iankeeffe1/hellen-example/boards/hellen64_miataNA6_94-a/board/misc/hellen64_miataNA6_94-a-bottom.png

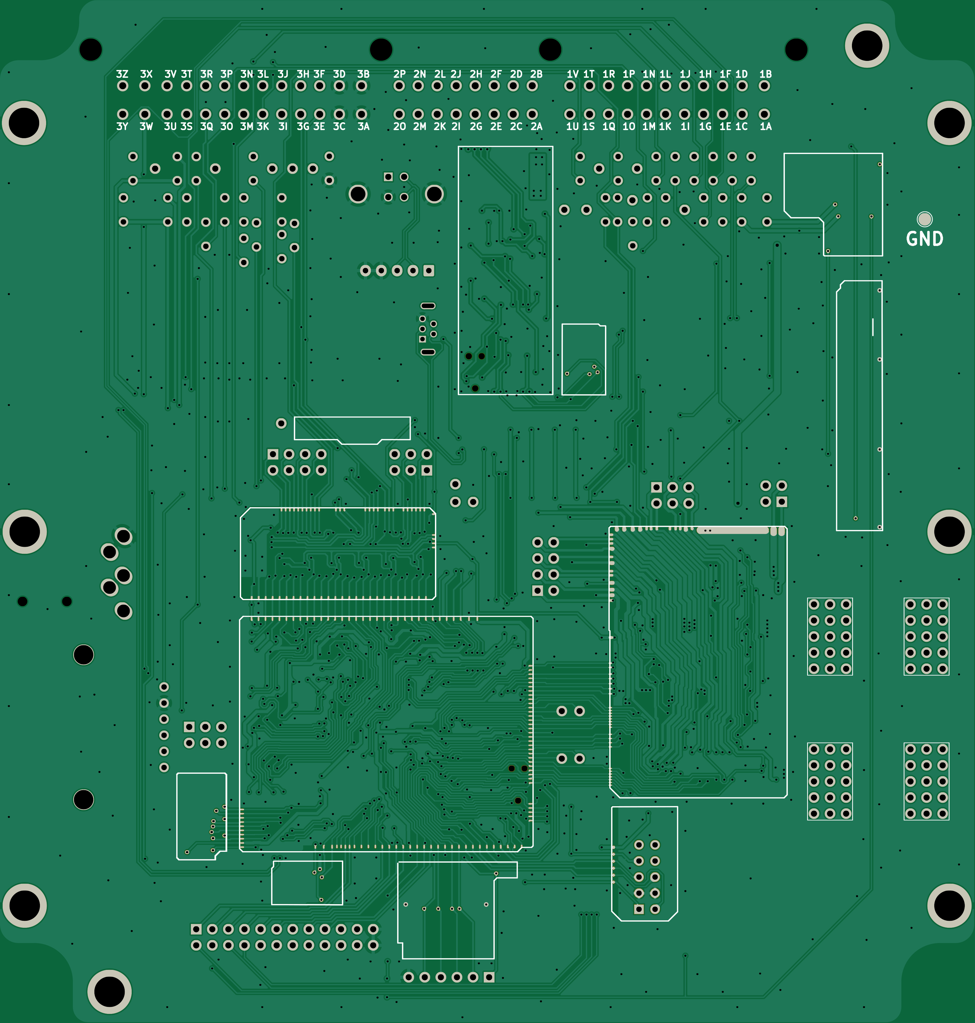
boards/hellen64_miataNA6_94-a/board/misc/hellen64_miataNA6_94-a-bottom.png
