iankeeffe1/hellen-example/boards/hellen64_miataNA6_94-a/board/Produce_DanZhi.SMT_Original_Snapshot.Top.2582135A_Y98.SMT0210416179401.png

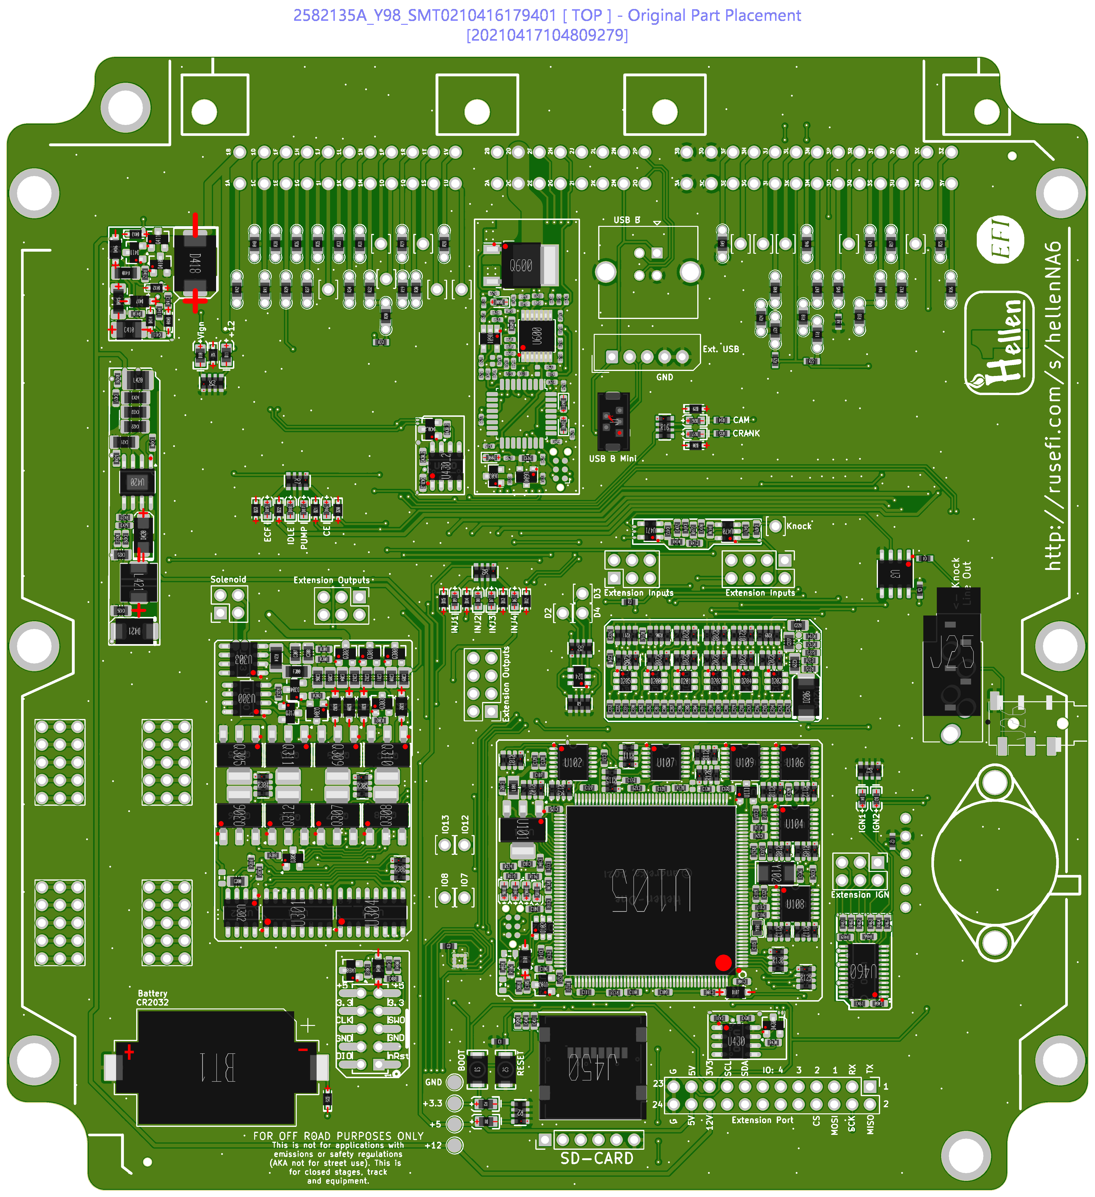
boards/hellen64_miataNA6_94-a/board/Produce_DanZhi.SMT_Original_Snapshot.Top.2582135A_Y98.SMT0210416179401.png
