iankeeffe1/hellen-example/boards/hellen64_miataNA6_94-b/board/hellen64_miataNA6_94-b.png

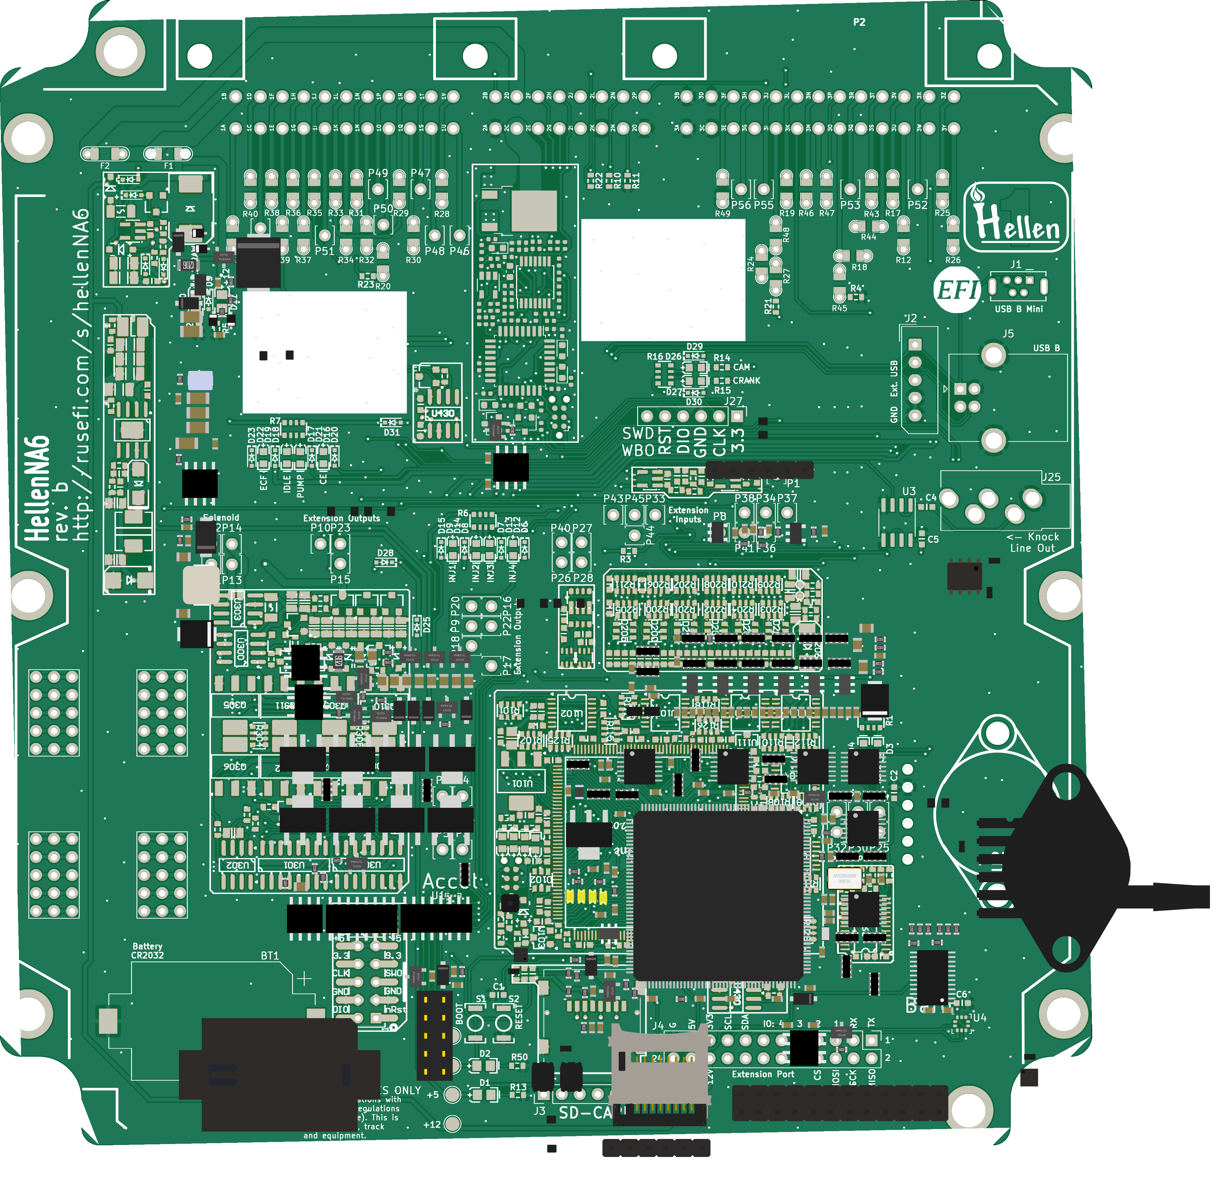
boards/hellen64_miataNA6_94-b/board/hellen64_miataNA6_94-b.png
