iankeeffe1/hellen-example/boards/hellen64_miataNA6_94-b/board/misc/hellen64_miataNA6_94-b-top.png

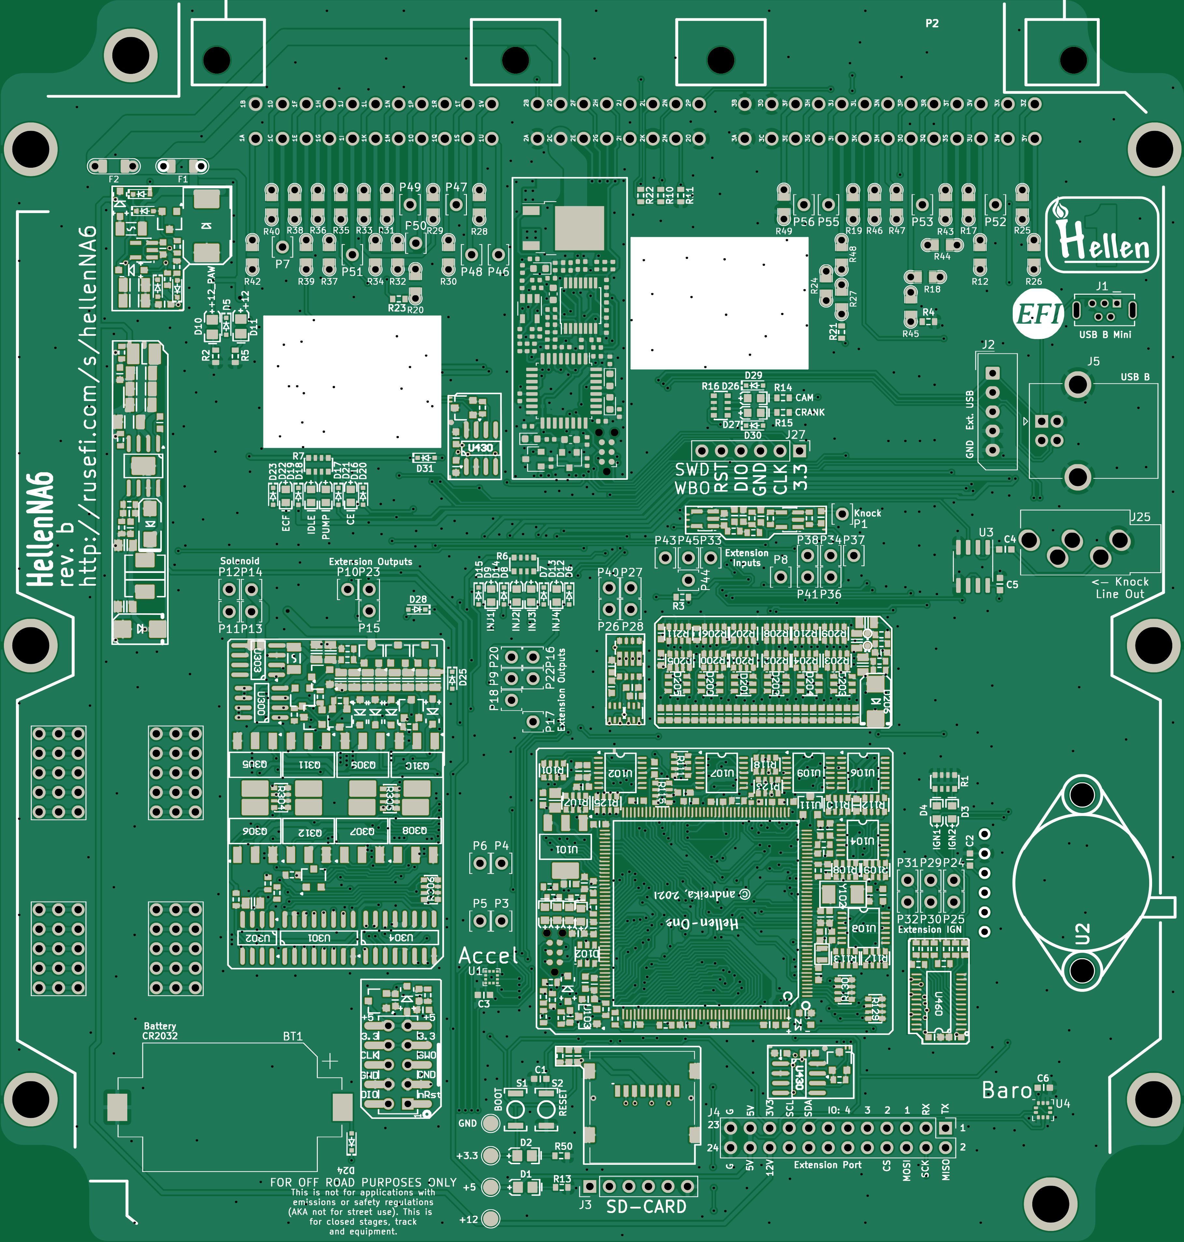
boards/hellen64_miataNA6_94-b/board/misc/hellen64_miataNA6_94-b-top.png
