iankeeffe1/hellen-example/boards/hellen64_NA6_94-c/board/hellen64_NA6_94-c.png

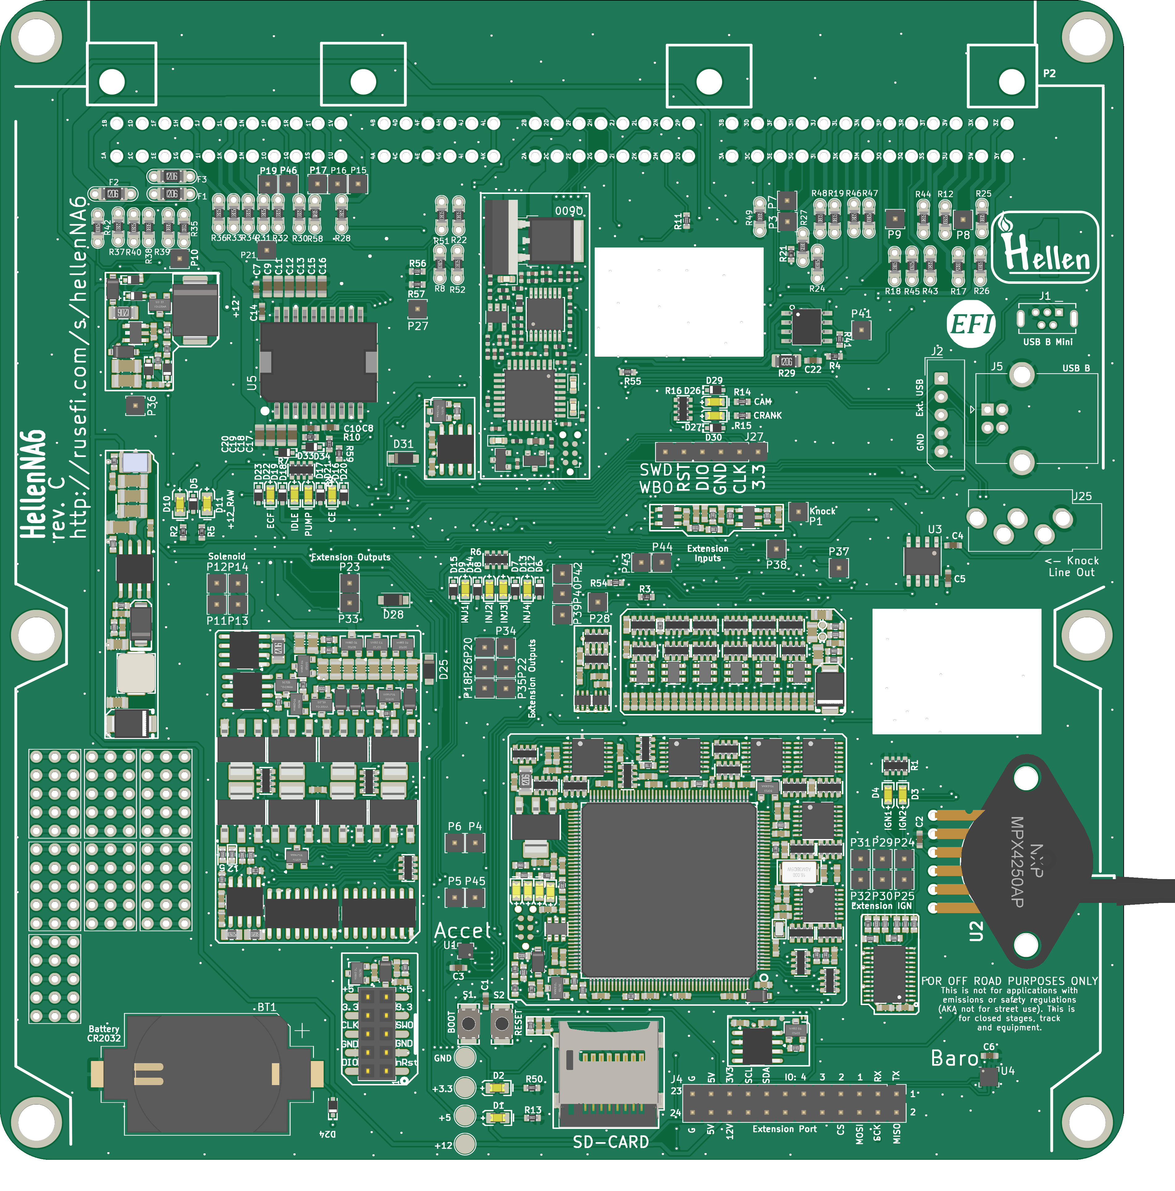
boards/hellen64_NA6_94-c/board/hellen64_NA6_94-c.png
