iankeeffe1/hellen-example/boards/hellen64_NA6_94-c/board/misc/hellen64_NA6_94-c-outline.png

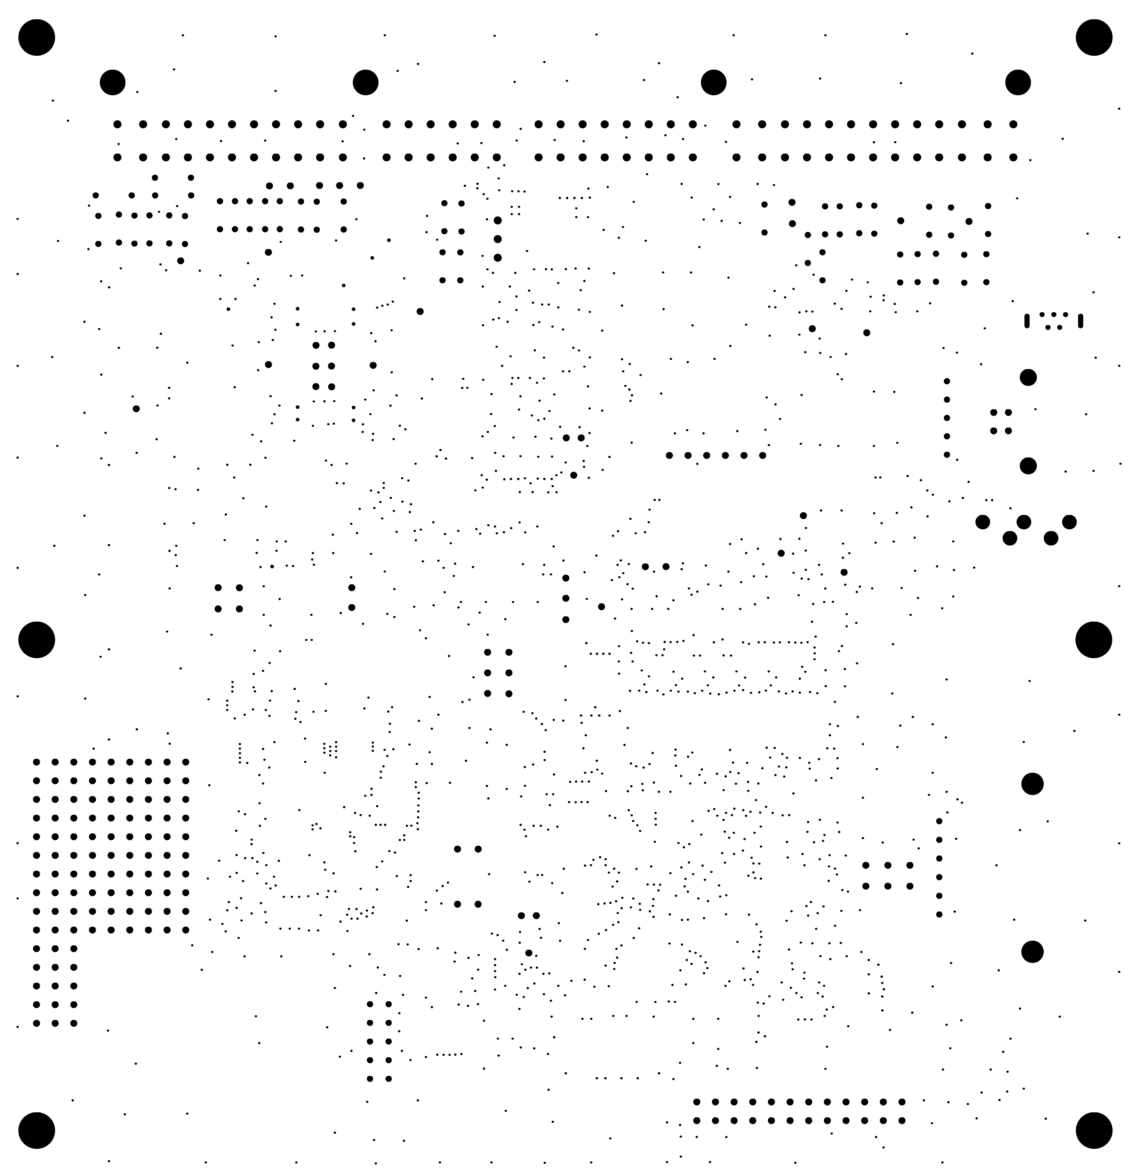
boards/hellen64_NA6_94-c/board/misc/hellen64_NA6_94-c-outline.png
