iankeeffe1/hellen-example/boards/hellen64_NA6_94-d/board/hellen64_NA6_94-d.png

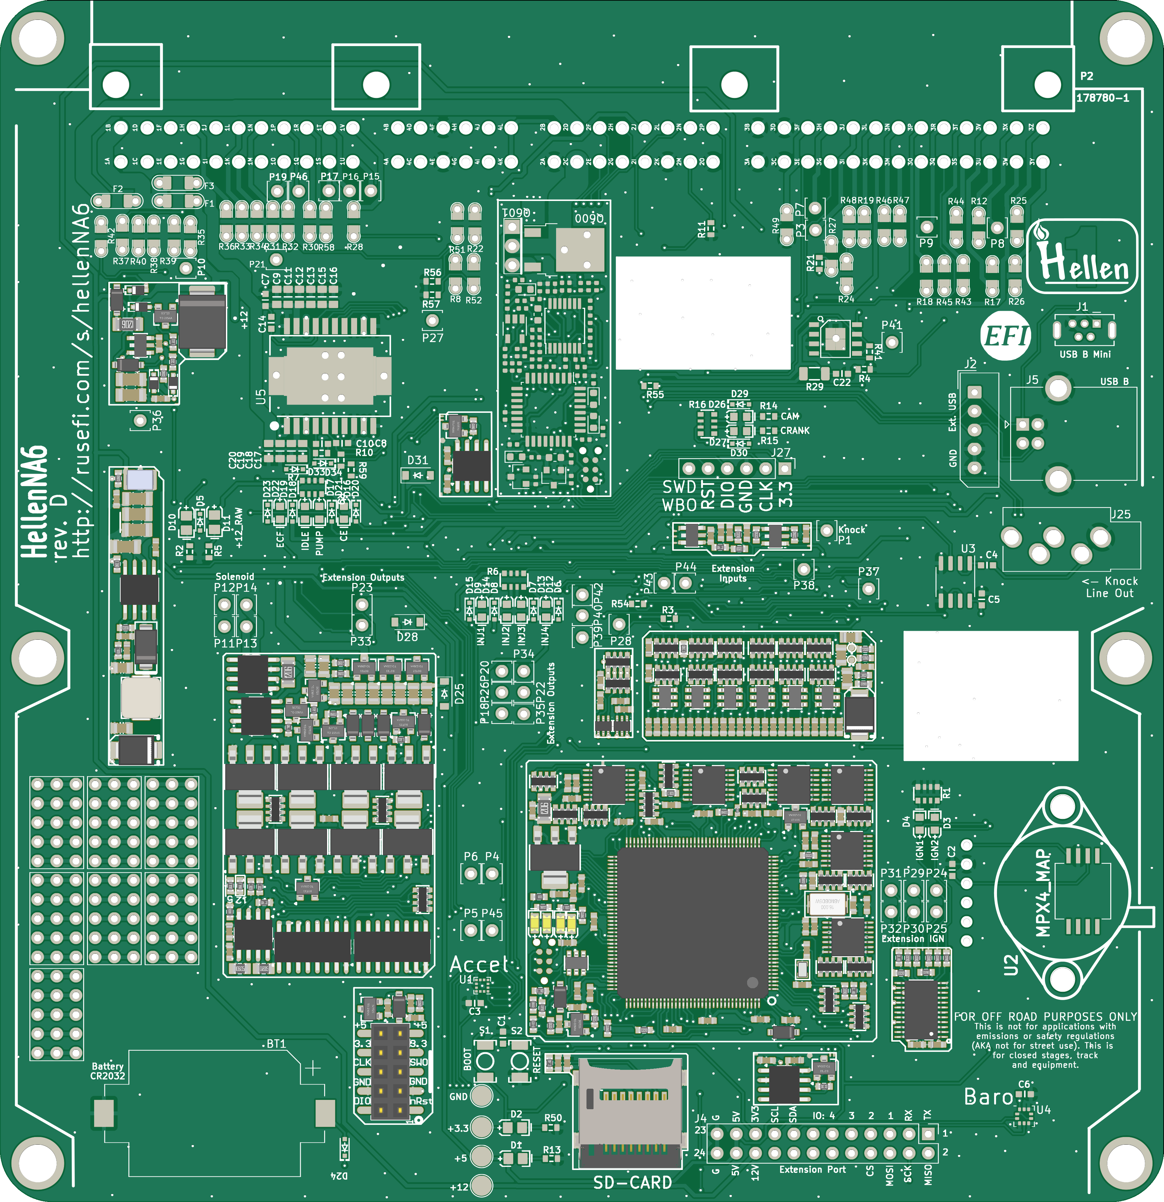
boards/hellen64_NA6_94-d/board/hellen64_NA6_94-d.png
