iankeeffe1/hellen-example/boards/hellen64_NA6_94-d/board/misc/hellen64_NA6_94-d-components.png

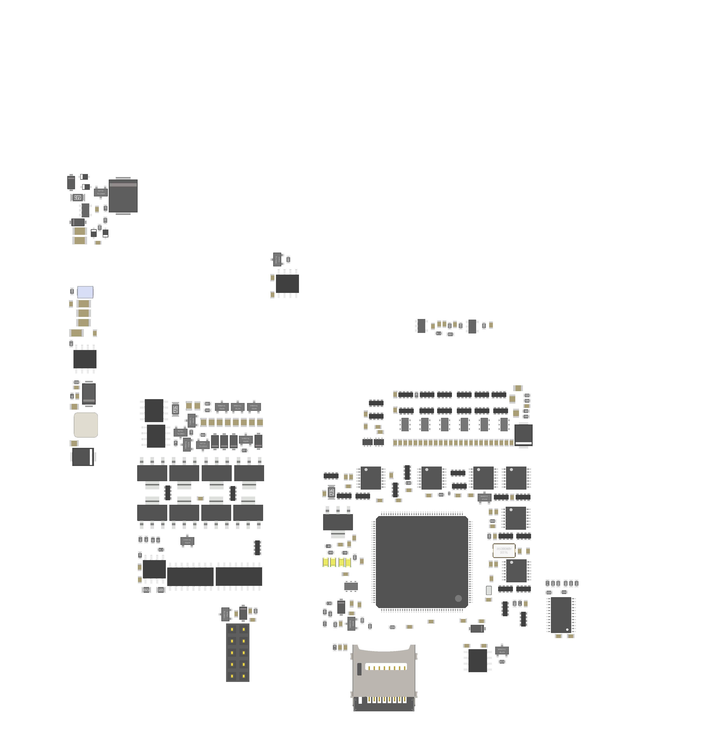
boards/hellen64_NA6_94-d/board/misc/hellen64_NA6_94-d-components.png
