iankeeffe1/hellen-example/boards/hellen64_miataNA6_94-a/board/hellen64_miataNA6_94-a-schematic.pdf

# P55 P52 P53P54 R43 R44 R45 R46 R47 R48 P56

1 D- 2 D+

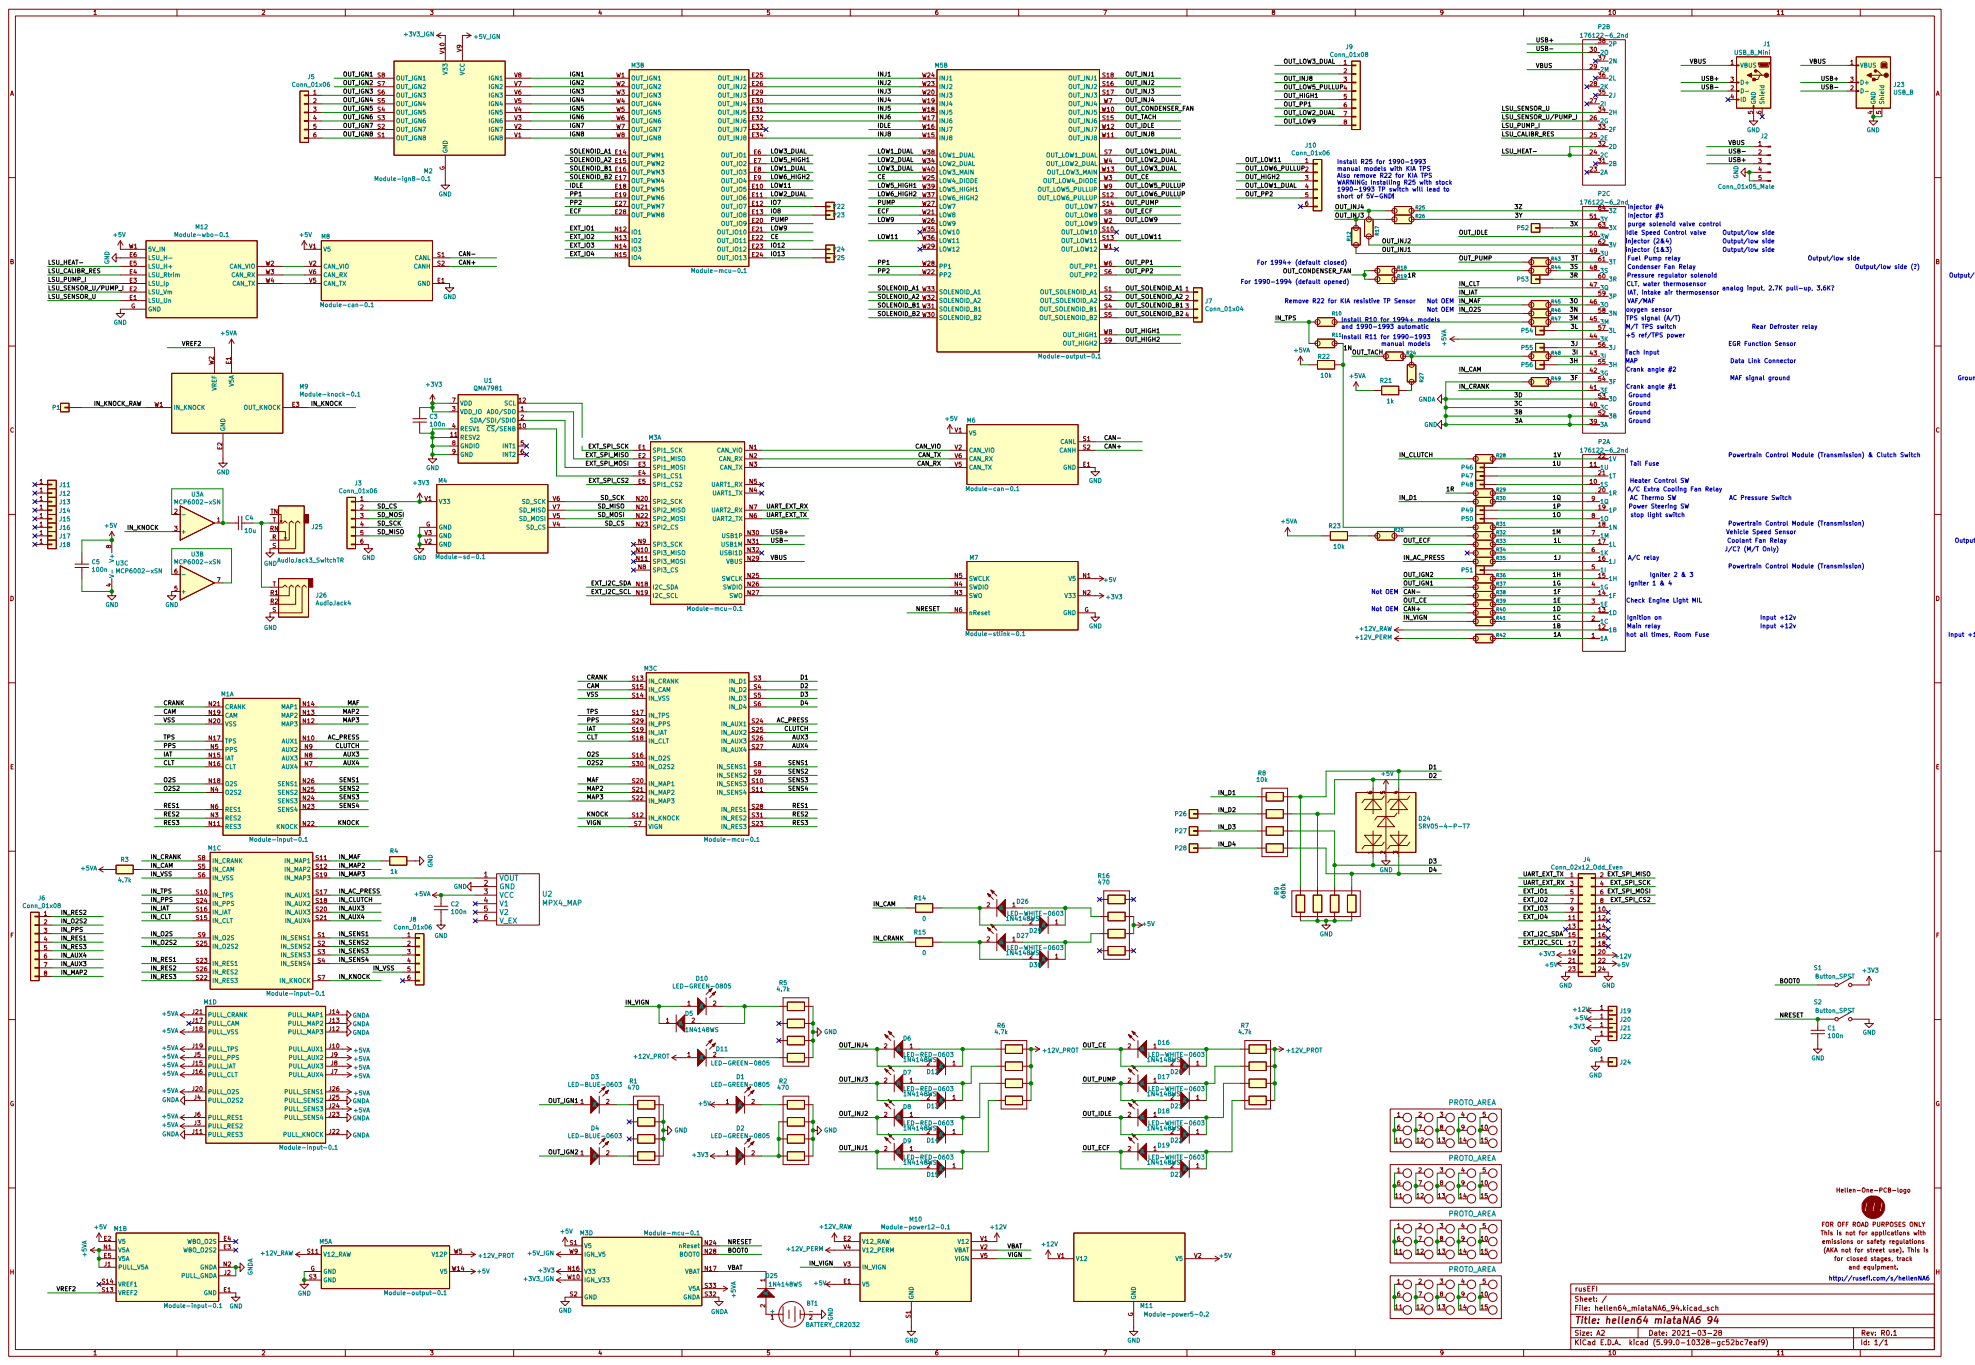
[picture p30: page 1]

Install R25 for 1990-1993 manual models with KIA TPS

Also remove R22 for KIA TPS WARNING: Installing R25 with stock 1990-1993 TP switch will lead to

Injector #4
Injector #3
purge solenoid valve control
Idle Speed Control valve
injector (2&4)
injector (1&3)
Fuel Pump relay Output/low side
Condenser Fan Relay Output/low side (?)
Pressure regulator solenoid Output/low side
IAT, intake air thermosensor CLT, water thermosensor oxygen sensor VAF/MAF

analog input, 2.7K pull-up, 3.6K?

Install R10 for 1994+ models and 1990-1993 automatic

TPS signal (A/T)
Crank angle #2 M/T TPS switch Tach Input
+5 ref/TPS power

MAF signal ground Ground Data Link Connector EGR Function Sensor

Ground Ground Ground MAPCrank angle #1

stop light switch Heater Control SW
A/C Extra Cooling Fan Relay

Coolant Fan Relay Output, low-side
J/C? (M/T Only)

Powertrain Control Module (Transmission)

Ignition on Input +12v Not OEM

Main relay Input +12v
hot all times, Room Fuse Input +12v

for closed stages, track FOR OFF ROAD PURPOSES ONLY
This is not for applications with
emissions or safety regulations
(AKA not for street use). This is

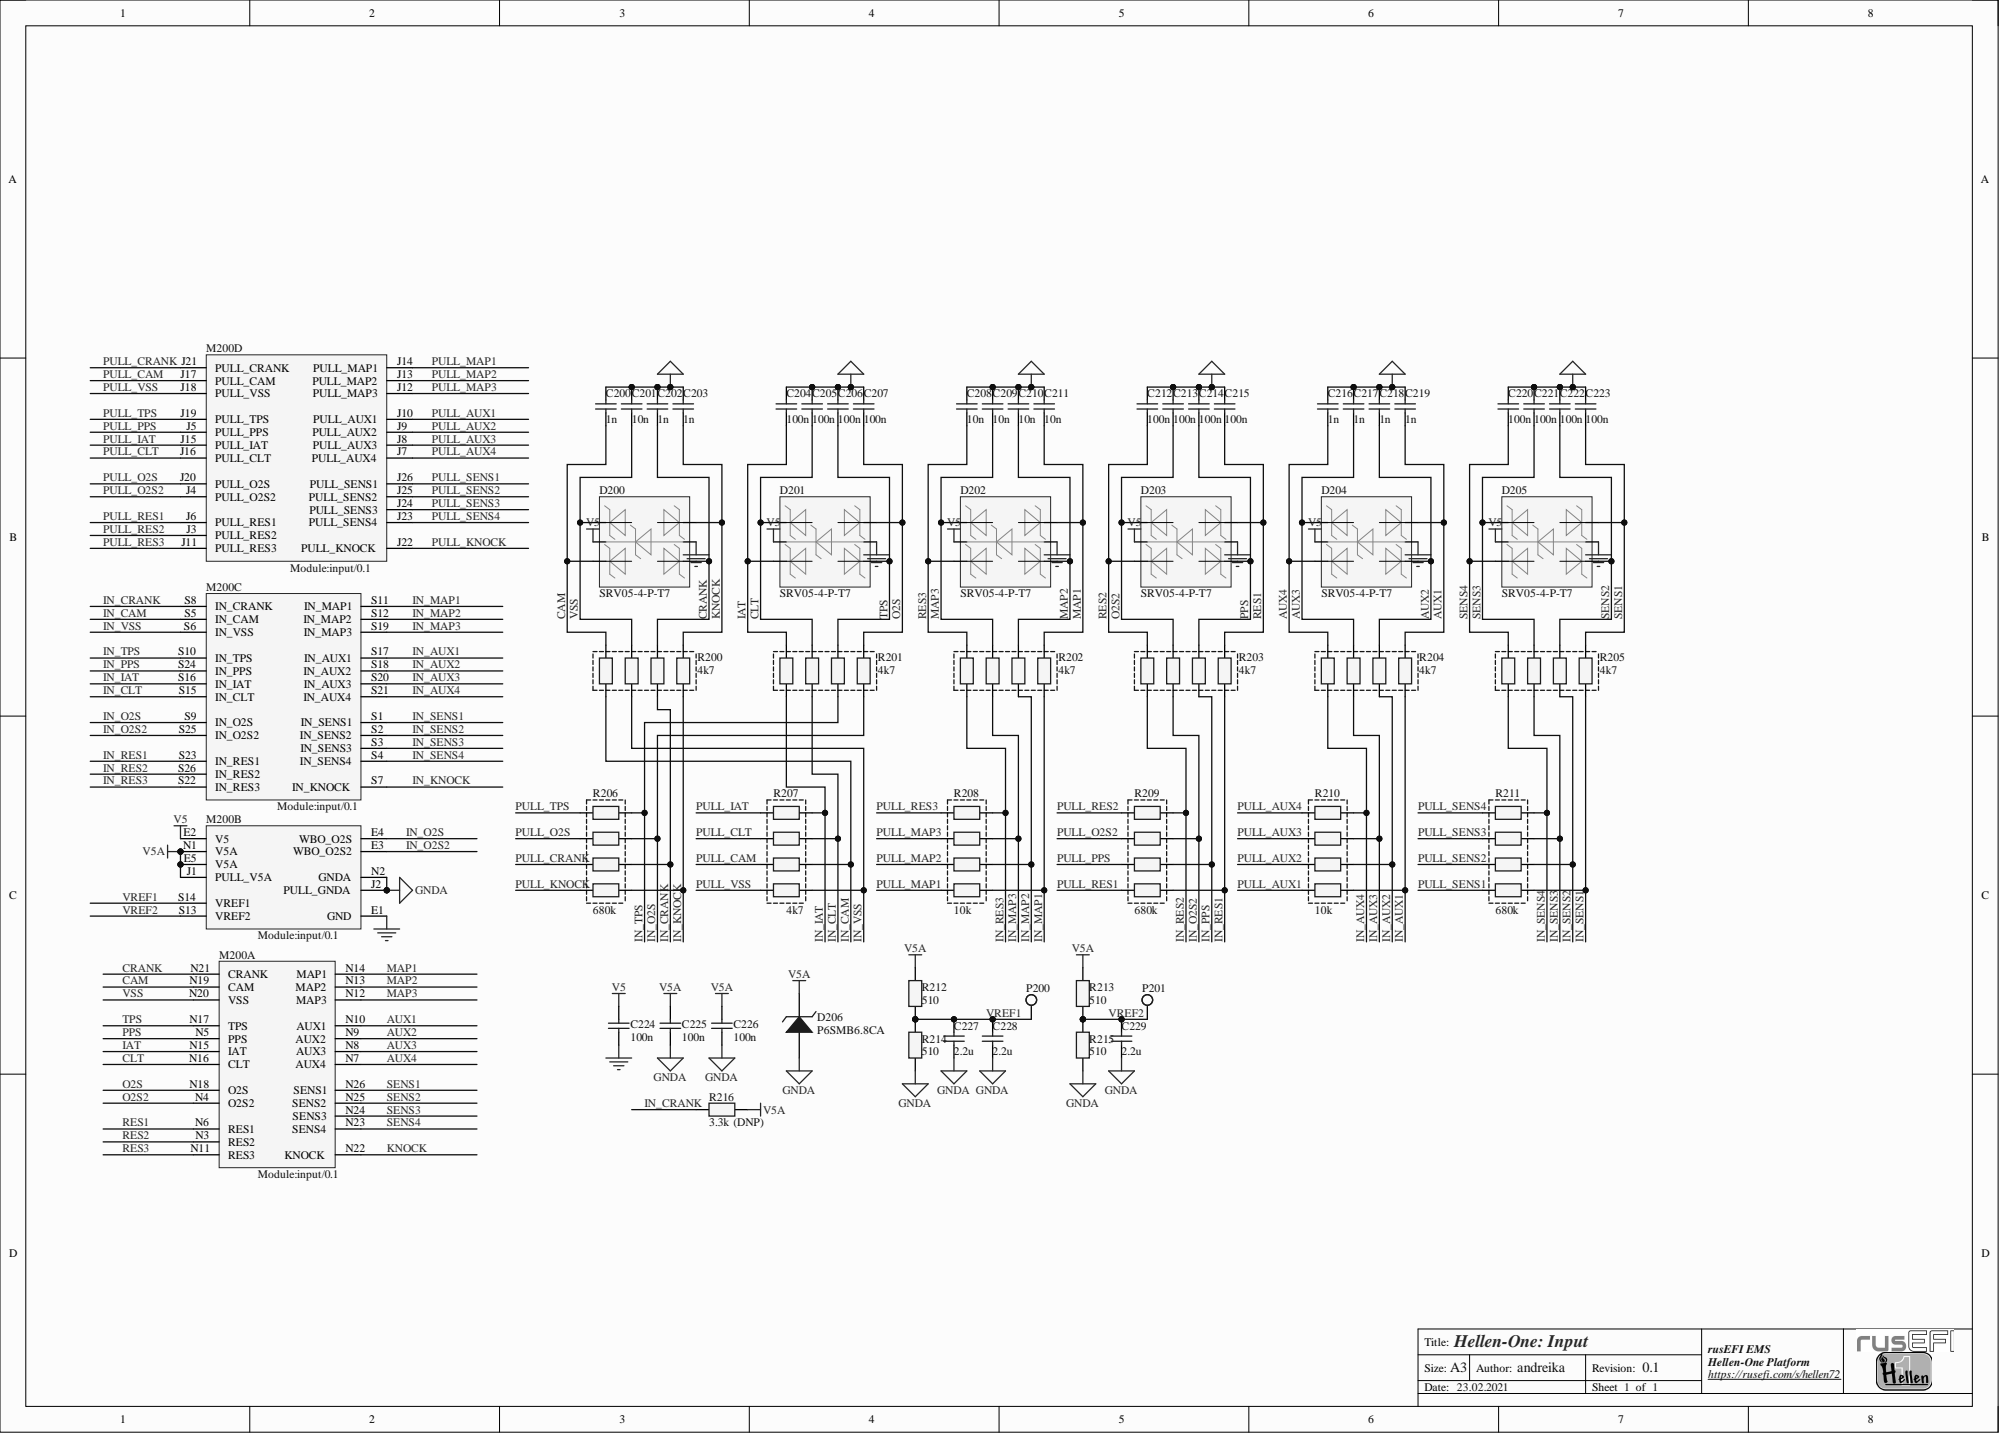
[picture p31: page 2]

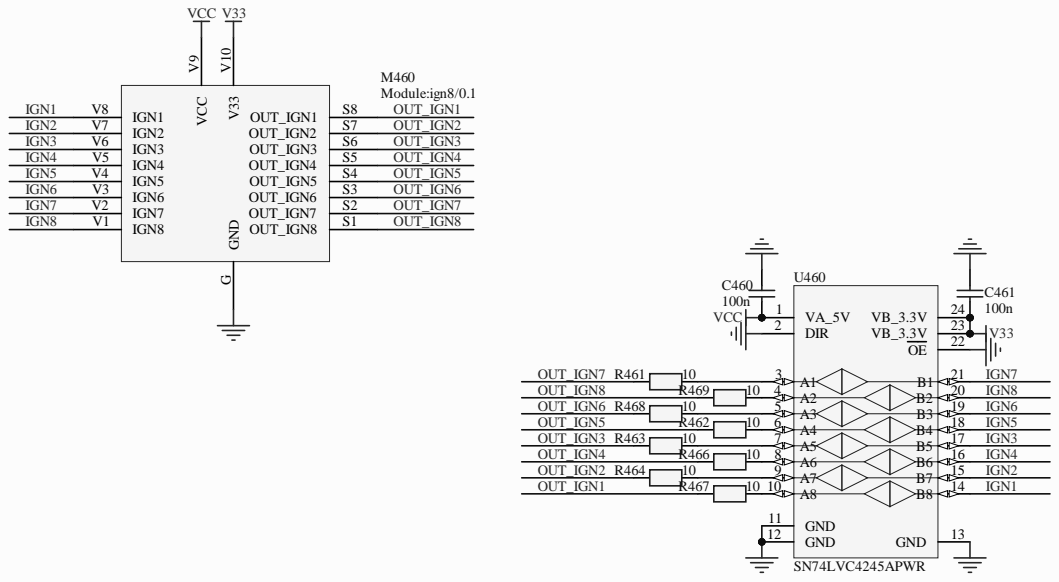
[picture p32: page 3]

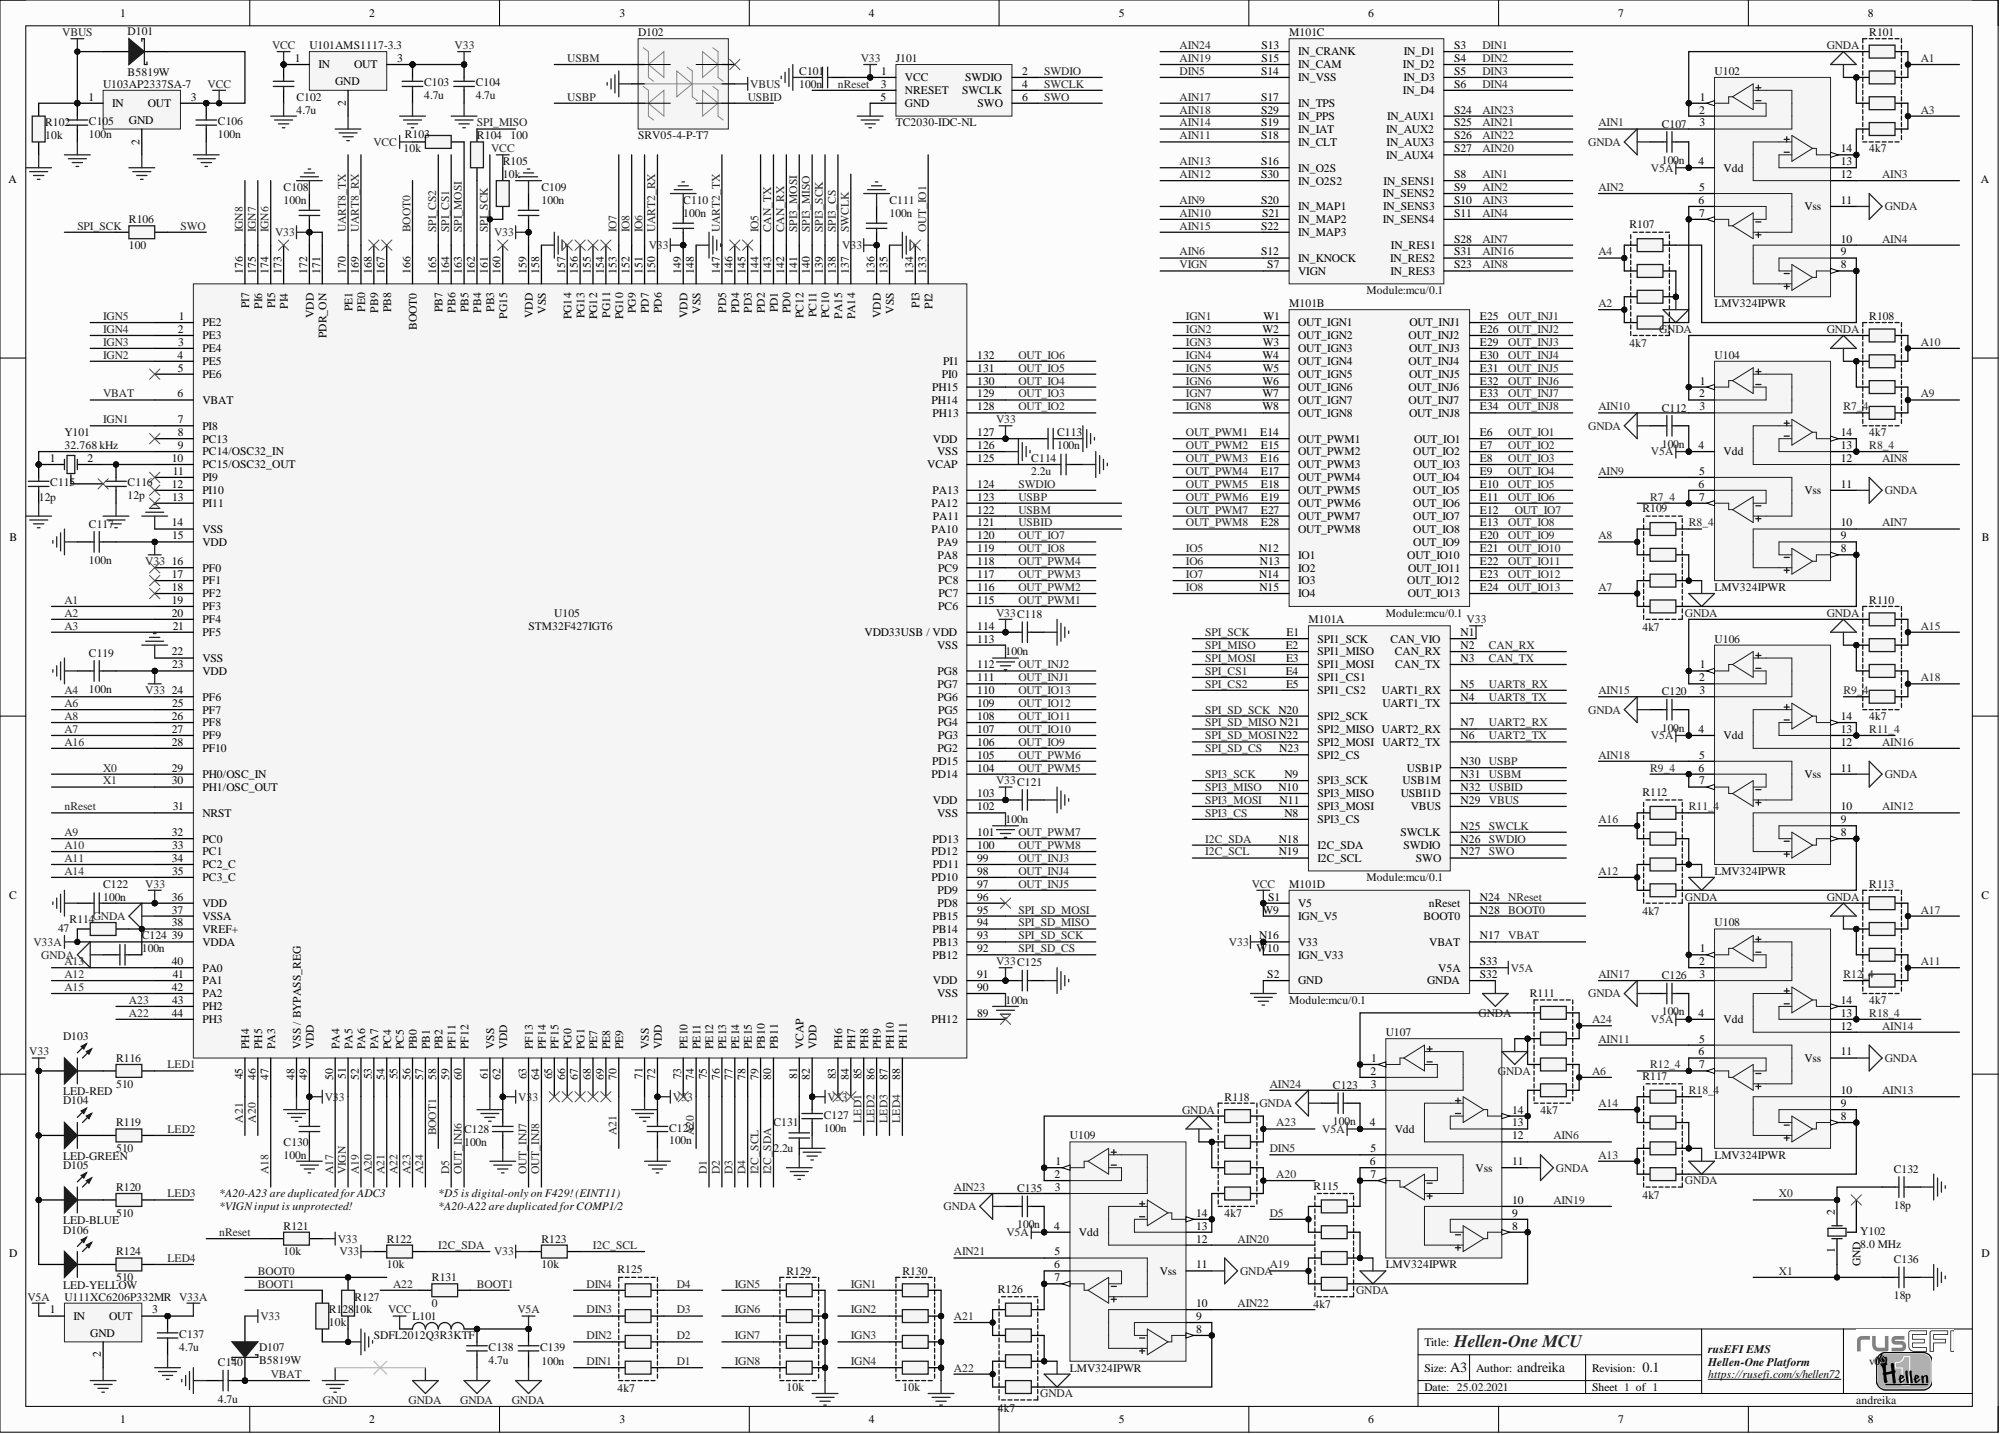
[picture p33: page 4]

D5 *D5 is digital-only on F429!(EINT11)

*A20-A23 are duplicated for ADC3
*VIGN input is unprotected!

2 SPI_I; 3 GND; 4 VCC; 5 SPI_SCK; 6 GND; 7 SPI_O; Molex MicroSD 47219-2001; GND; SD_CS SD_MOSI; SD_SCK; SD_MISO; V2 GND; SD_MOSI V5; SD_SCK V6 SD_MISO V7; Module:sd/0.1; SD_MOSI; SD_SCK SD_MISO

Hellen-One SD-Card

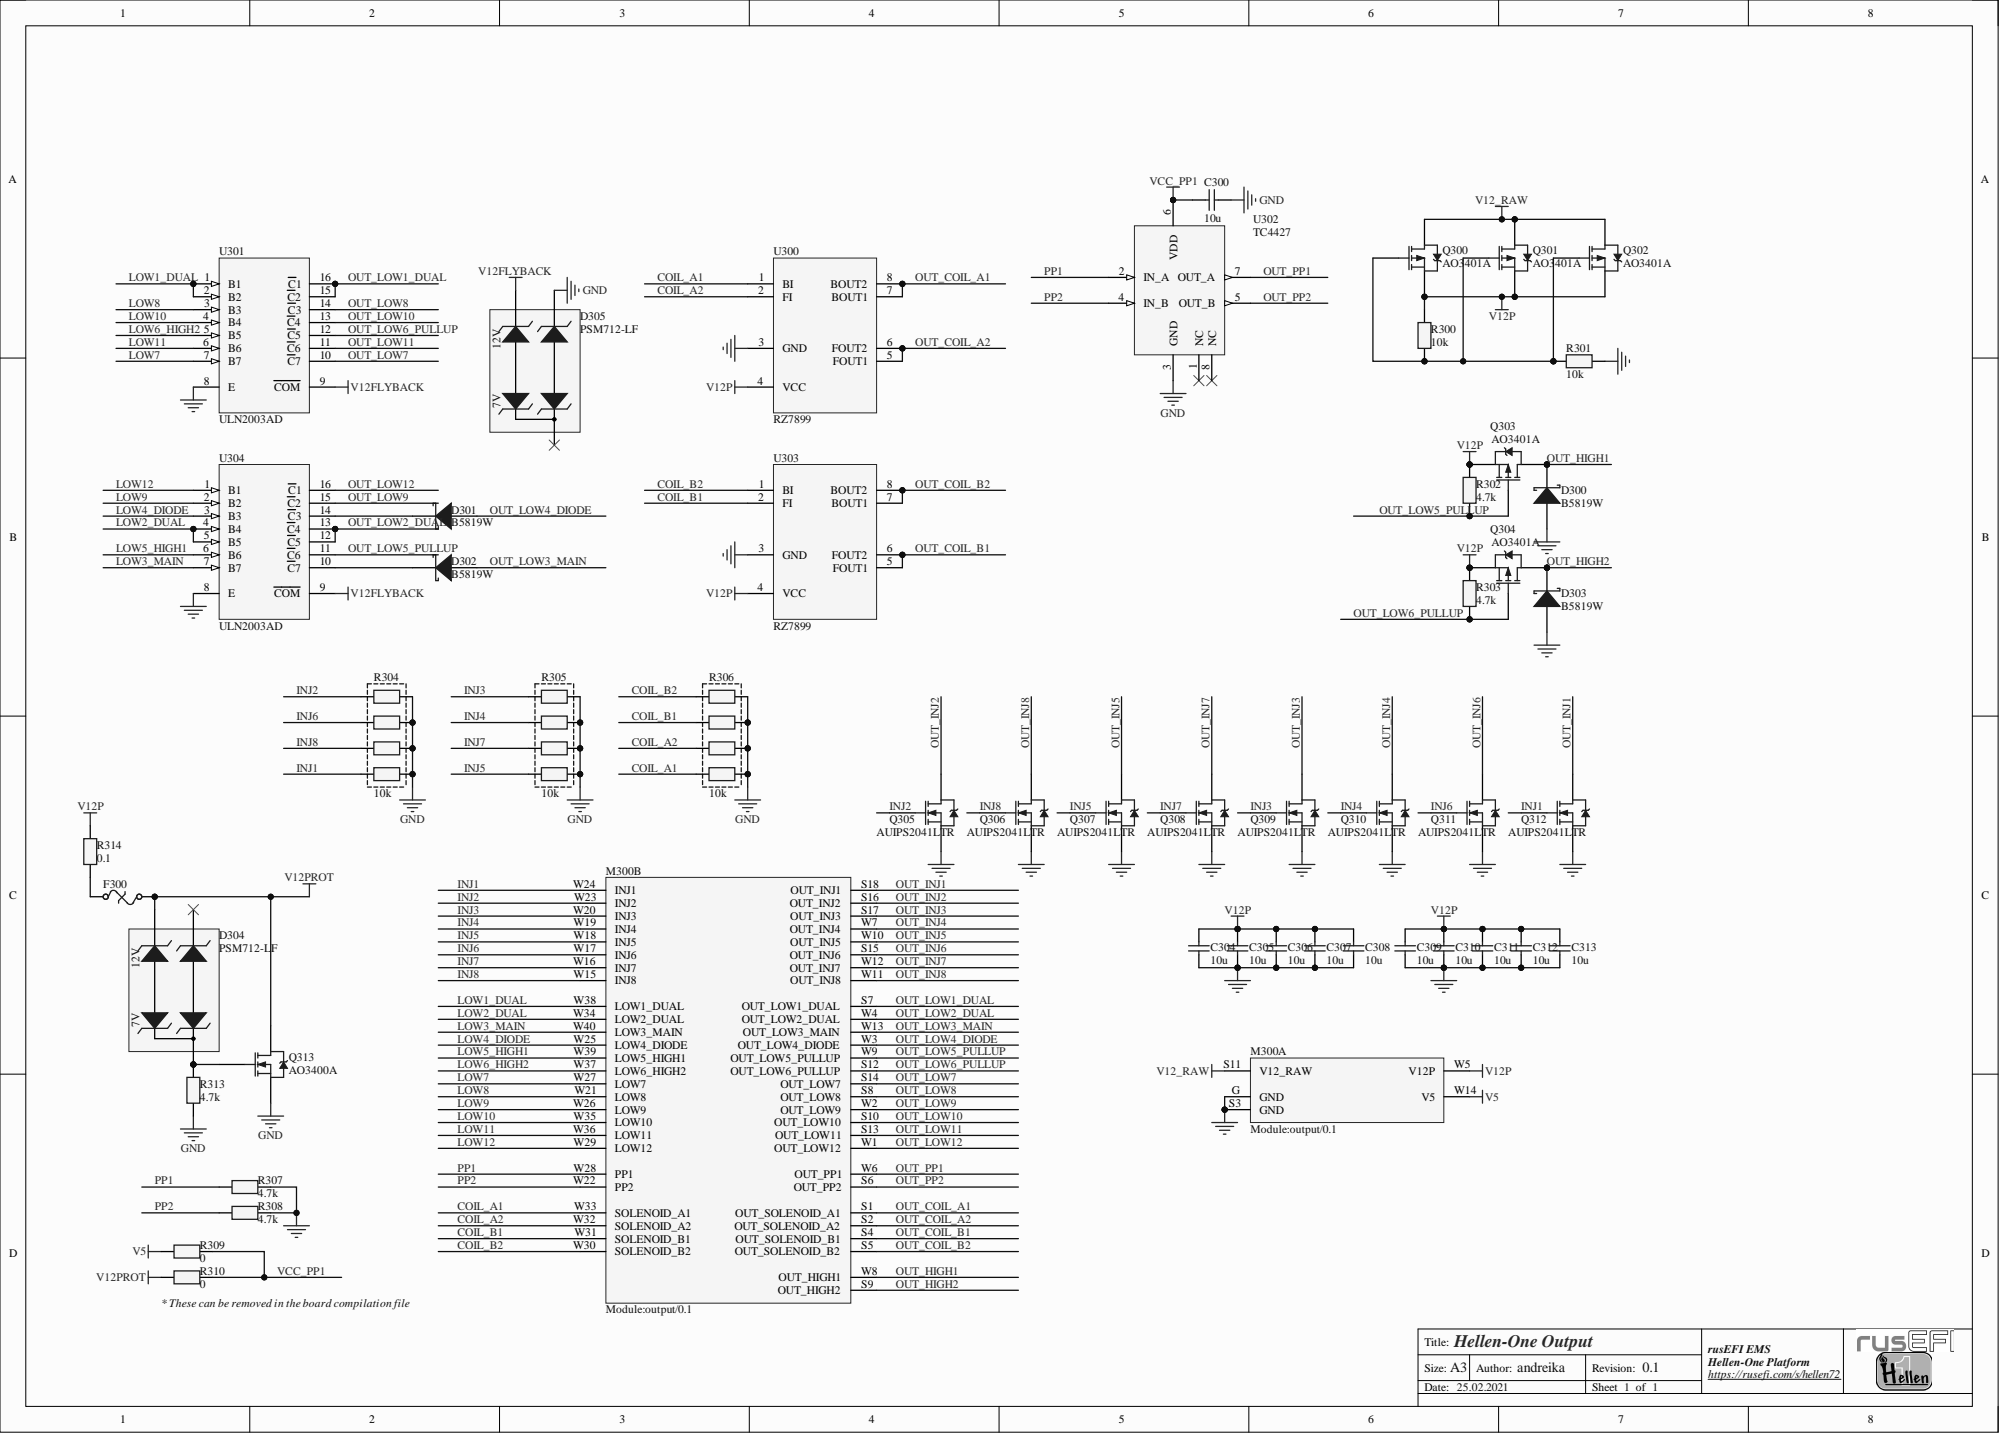
[picture p34: page 6]

* These can be removed in the board compilation file

PESD1CAN; GND; CANH; CANL; TXD 1 GND 2 VCC 3; Vio; 5 RXD 4; 6 CANH; TJA1051T/3/1J; CANH CANL; CAN_TX; CAN_RX; CAN_VIO; CAN_VIO V2; S2 CANL; CAN_TX V5; CAN_RX V6; Module:can/0.1

Hellen-One CAN

nReset 1; SWDIO; GND 3; GND; SWO 5; SWCLK; ST/Link 2x5; nReset; SWO; 2 OUT 3; SWO N3; SWDIO N4; N1 SWCLK N5; nReset N6; Module:stlink/0.1; SWDIO SWO

Hellen-One ST-Link


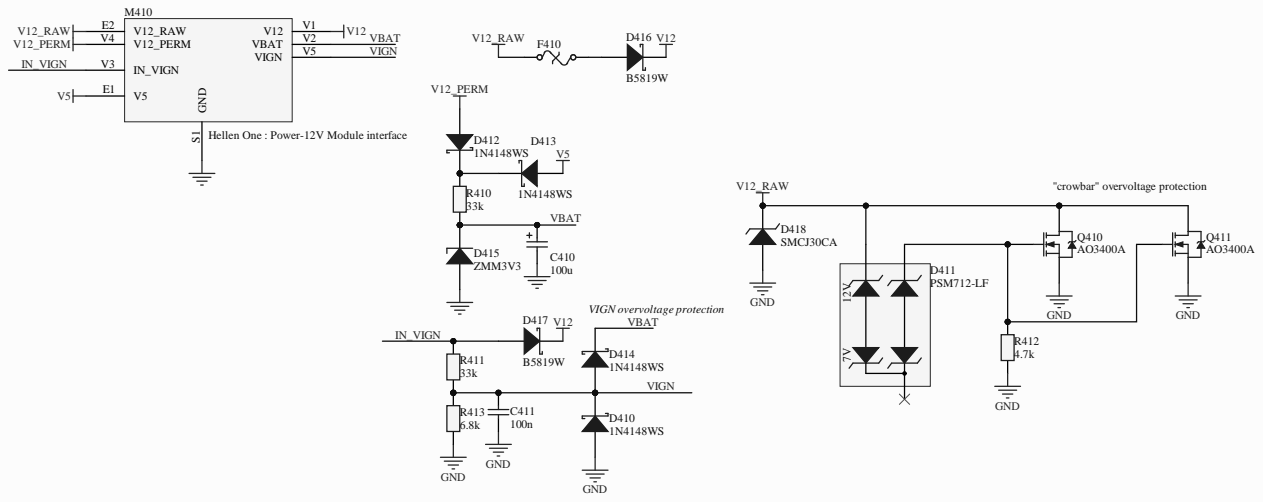
[picture p35: page 10]

Hellen One : Power-12V Module interface


# +5V GND

1u R625

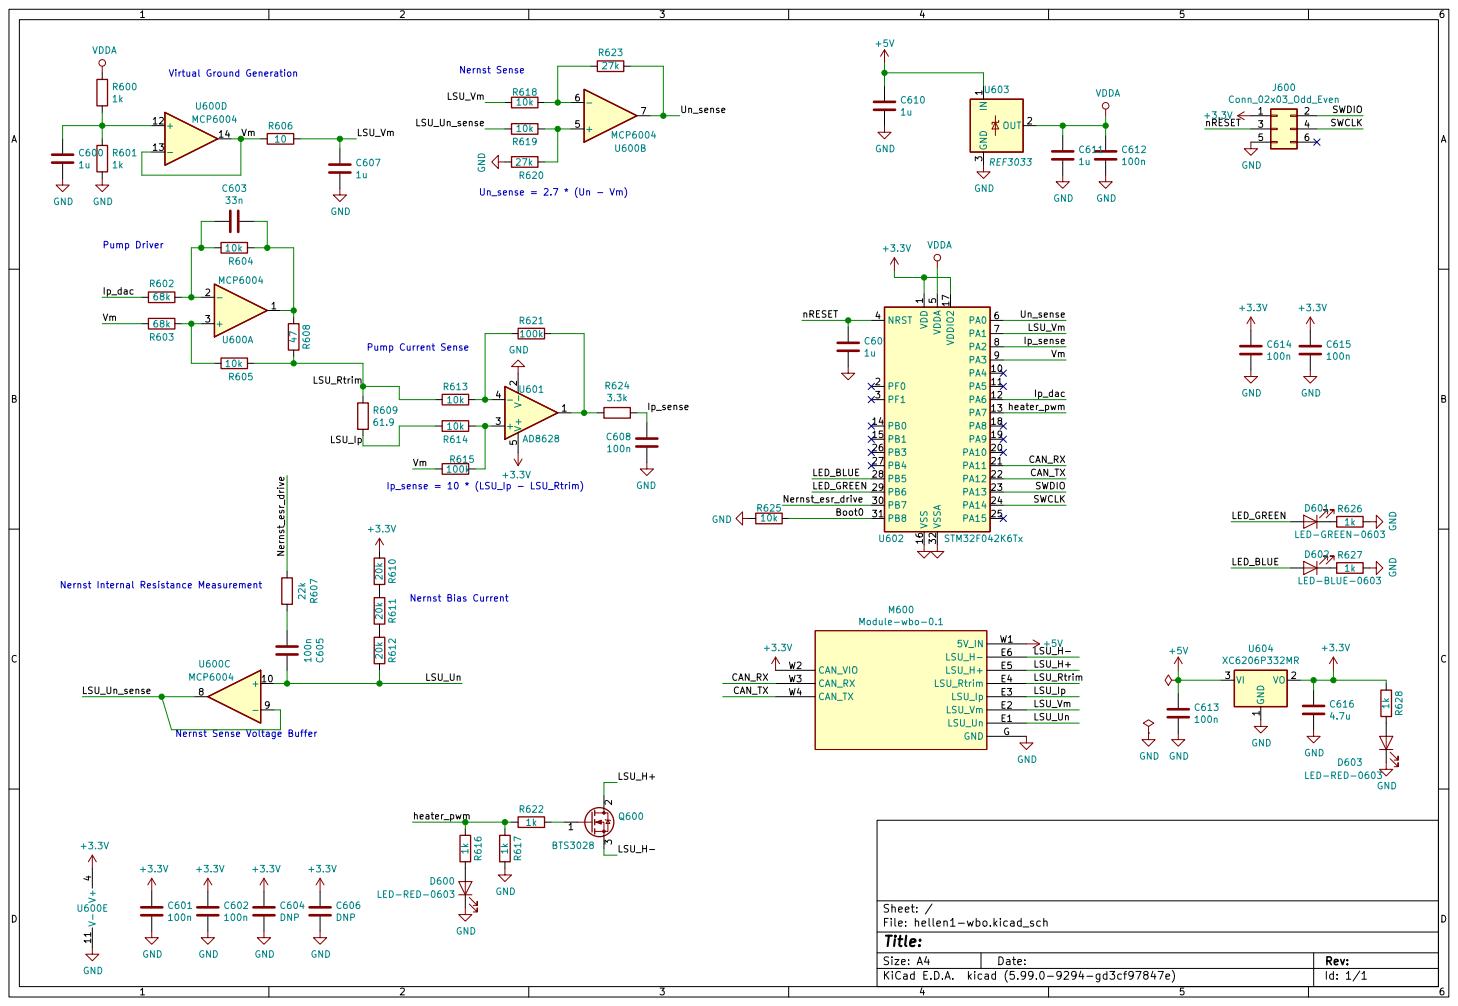
[picture p36: page 12]

1 PA4 10 PA5 11 PA6 12 PA7 13 PB0 14 PB1 15 VSS 16 VDDIO2 17 PA8 18 PA9 19 PF0 2 PA10 20 PA11 21 PA12 22 PA13 23 PA14 24 PA15 25 PB3 26 PB4 27 PB5 28 PB6 29 PF1 3 PB7 30 PB8 31 VSSA 32 NRST 4 VDDA

Nernst Sense Voltage Buffer
