iankeeffe1/hellen-example/boards/hellen64_miataNA6_94-a/frame/64_miataNA6_94-schematic.pdf

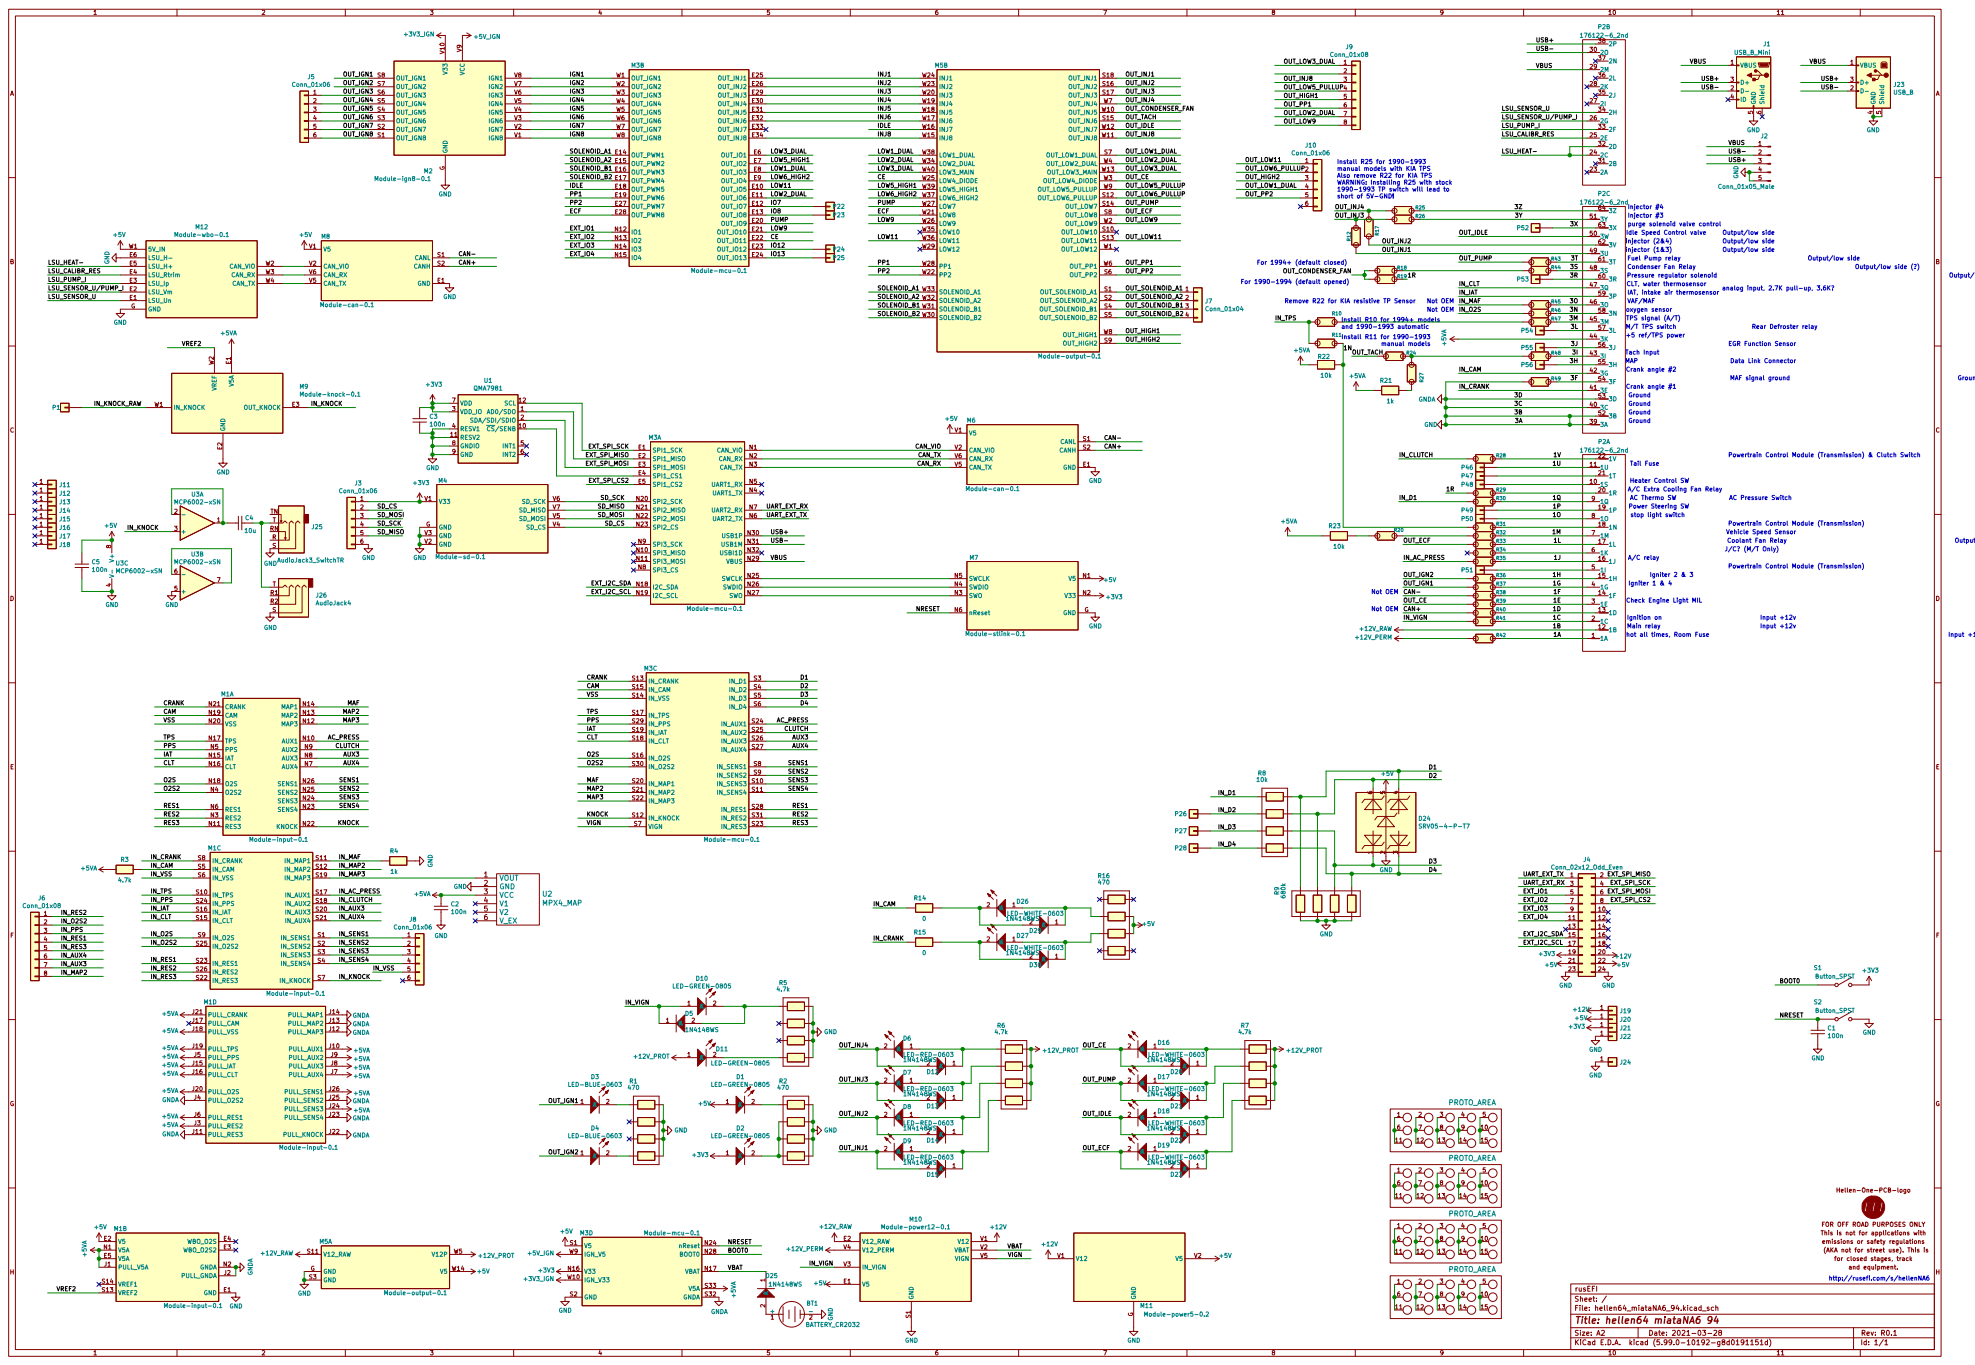
[picture p37: page 1]

Install R25 for 1990-1993 manual models with KIA TPS

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

analog input, 2.7K pull-up, 3.6K?

Powertrain Control Module (Transmission) VAF/MAF Not OEM

TPS signal (A/T)
Tach Input M/T TPS switch Crank angle #2
+5 ref/TPS power

MAPGround Ground Ground Crank angle #1

Data Link Connector MAF signal ground Ground

Powertrain Control Module (Transmission)

Vehicle Speed Sensor Not OEM

Coolant Fan Relay Output, low-side
J/C? (M/T Only)

Check Engine Light MIL

Ignition on Input +12v
Main relay Input +12v
hot all times, Room Fuse Input +12v

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
