iankeeffe1/hellen-example/boards/hellen64_NA6_94-c/board/hellen64_NA6_94-c-schematic.pdf

# P24 GND

# P8+5VAS GND GND GND

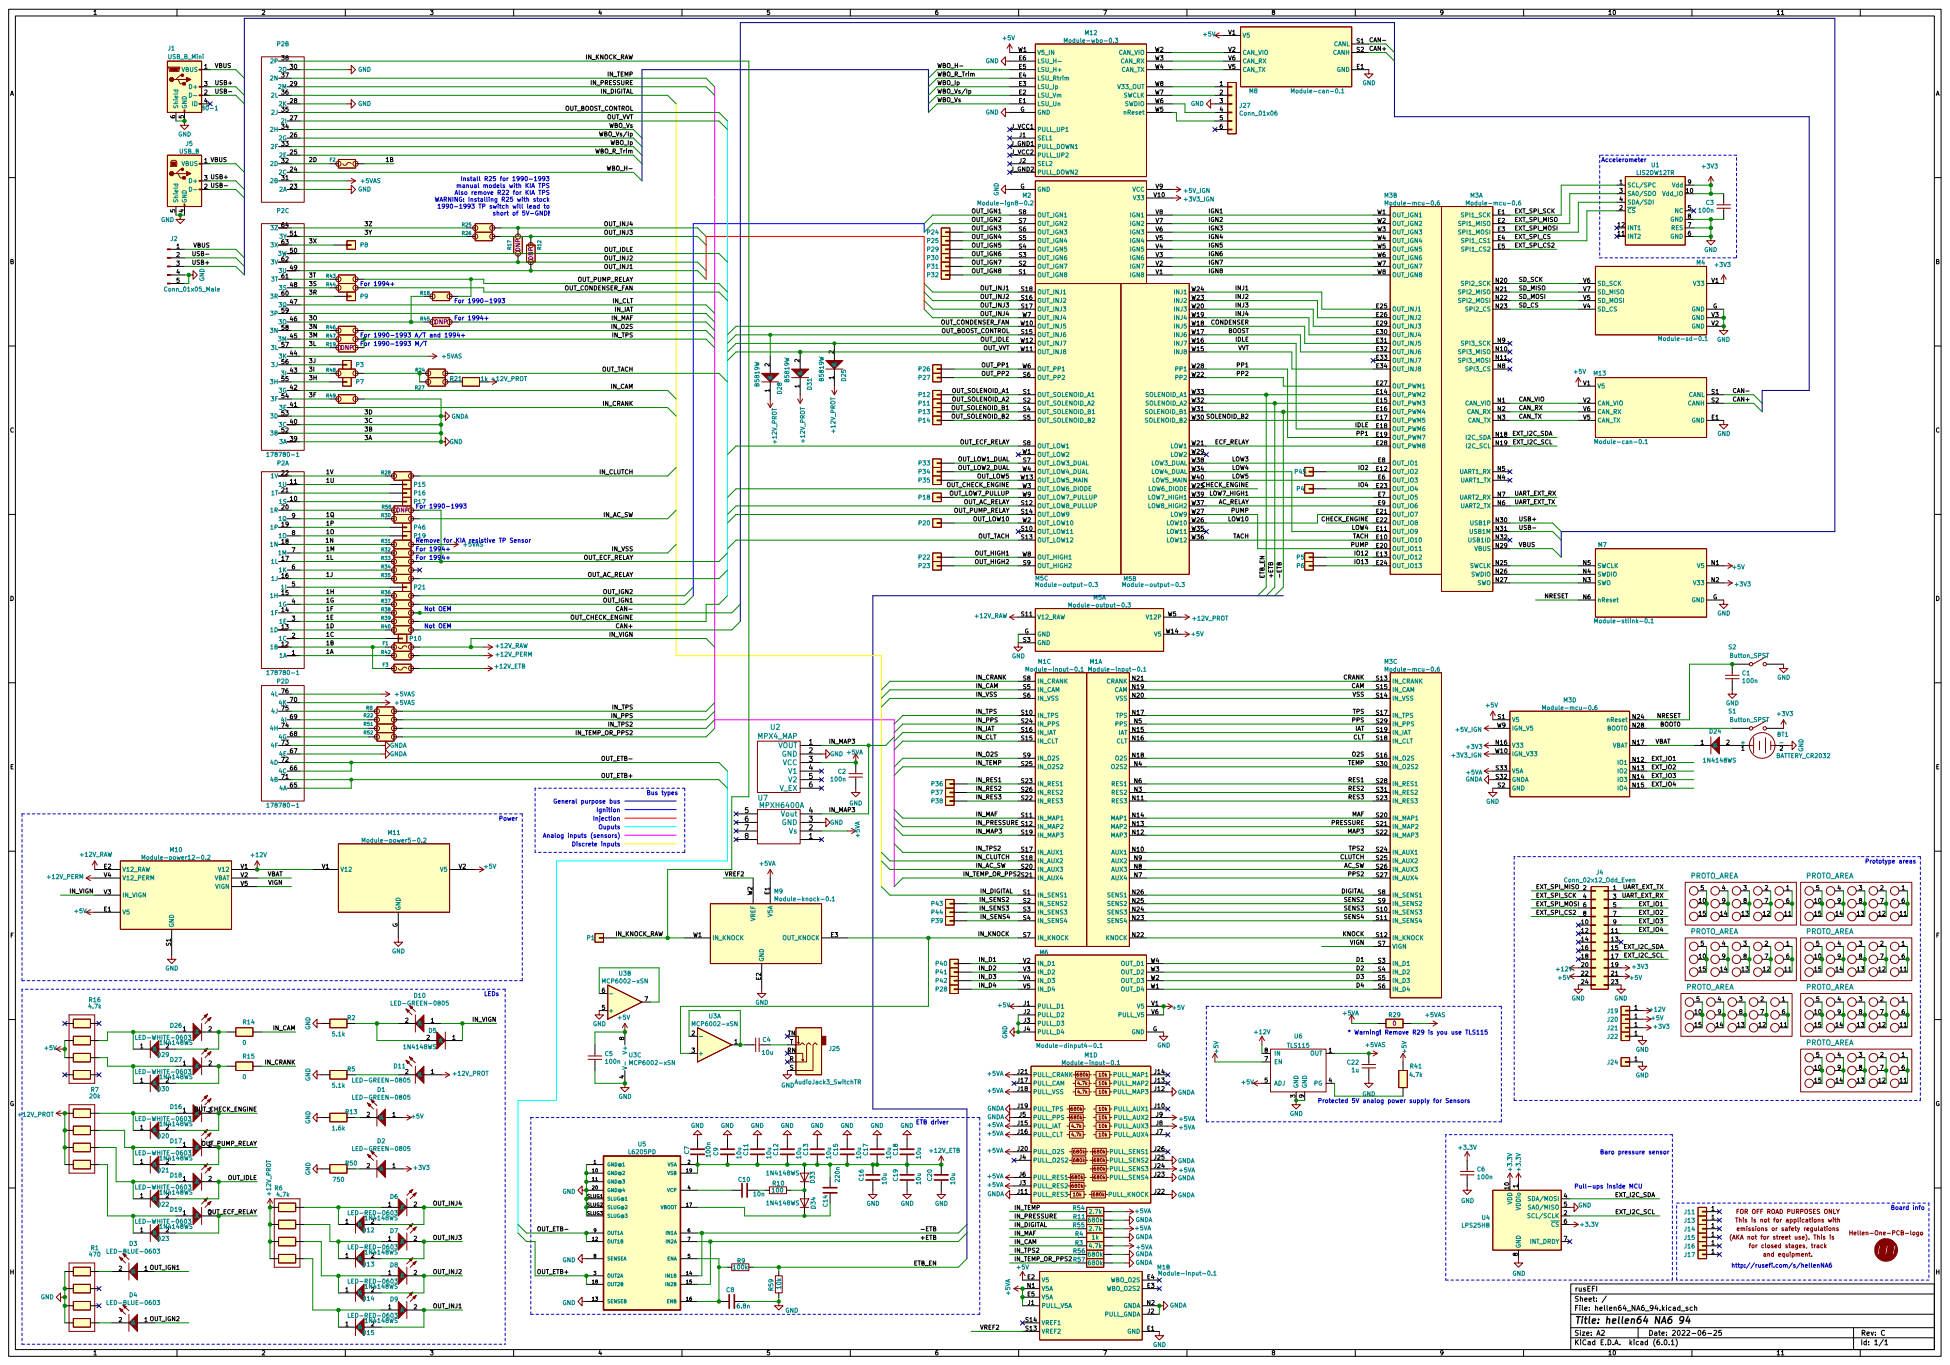
[picture p43: page 1]

Install R25 for 1990-1993 manual models with KIA TPS

Also remove R22 for KIA TPS WARNING: Installing R25 with stock 1990-1993 TP switch will lead to

short of 5V-GND! For 1994+

IAT N15 CLT N16 TPS N17 O2S N18 CAM N19 VSS N20 CRANK N21 KNOCK N22 SENS4 N23 SENS3 N24 SENS2 N25 SENS1 N26 RES2 N3 O2S2 N4 PPS N5 RES1 N6 AUX4 N7 AUX3 N8 AUX2 N9 M1AModule-input-0.1

* Warning! Remove R29 is you use TLS115

Board info Pull-ups inside MCU

for closed stages, track FOR OFF ROAD PURPOSES ONLY
This is not for applications with
emissions or safety regulations
(AKA not for street use). This is


tfo rm m/s/h; Size; Dat; Rev; Shee; _IGN; VCC; DIR; LVC4

Hellen-One IGN8 andreika

rusEFI EMS https://rusefi.co
Hellen-One

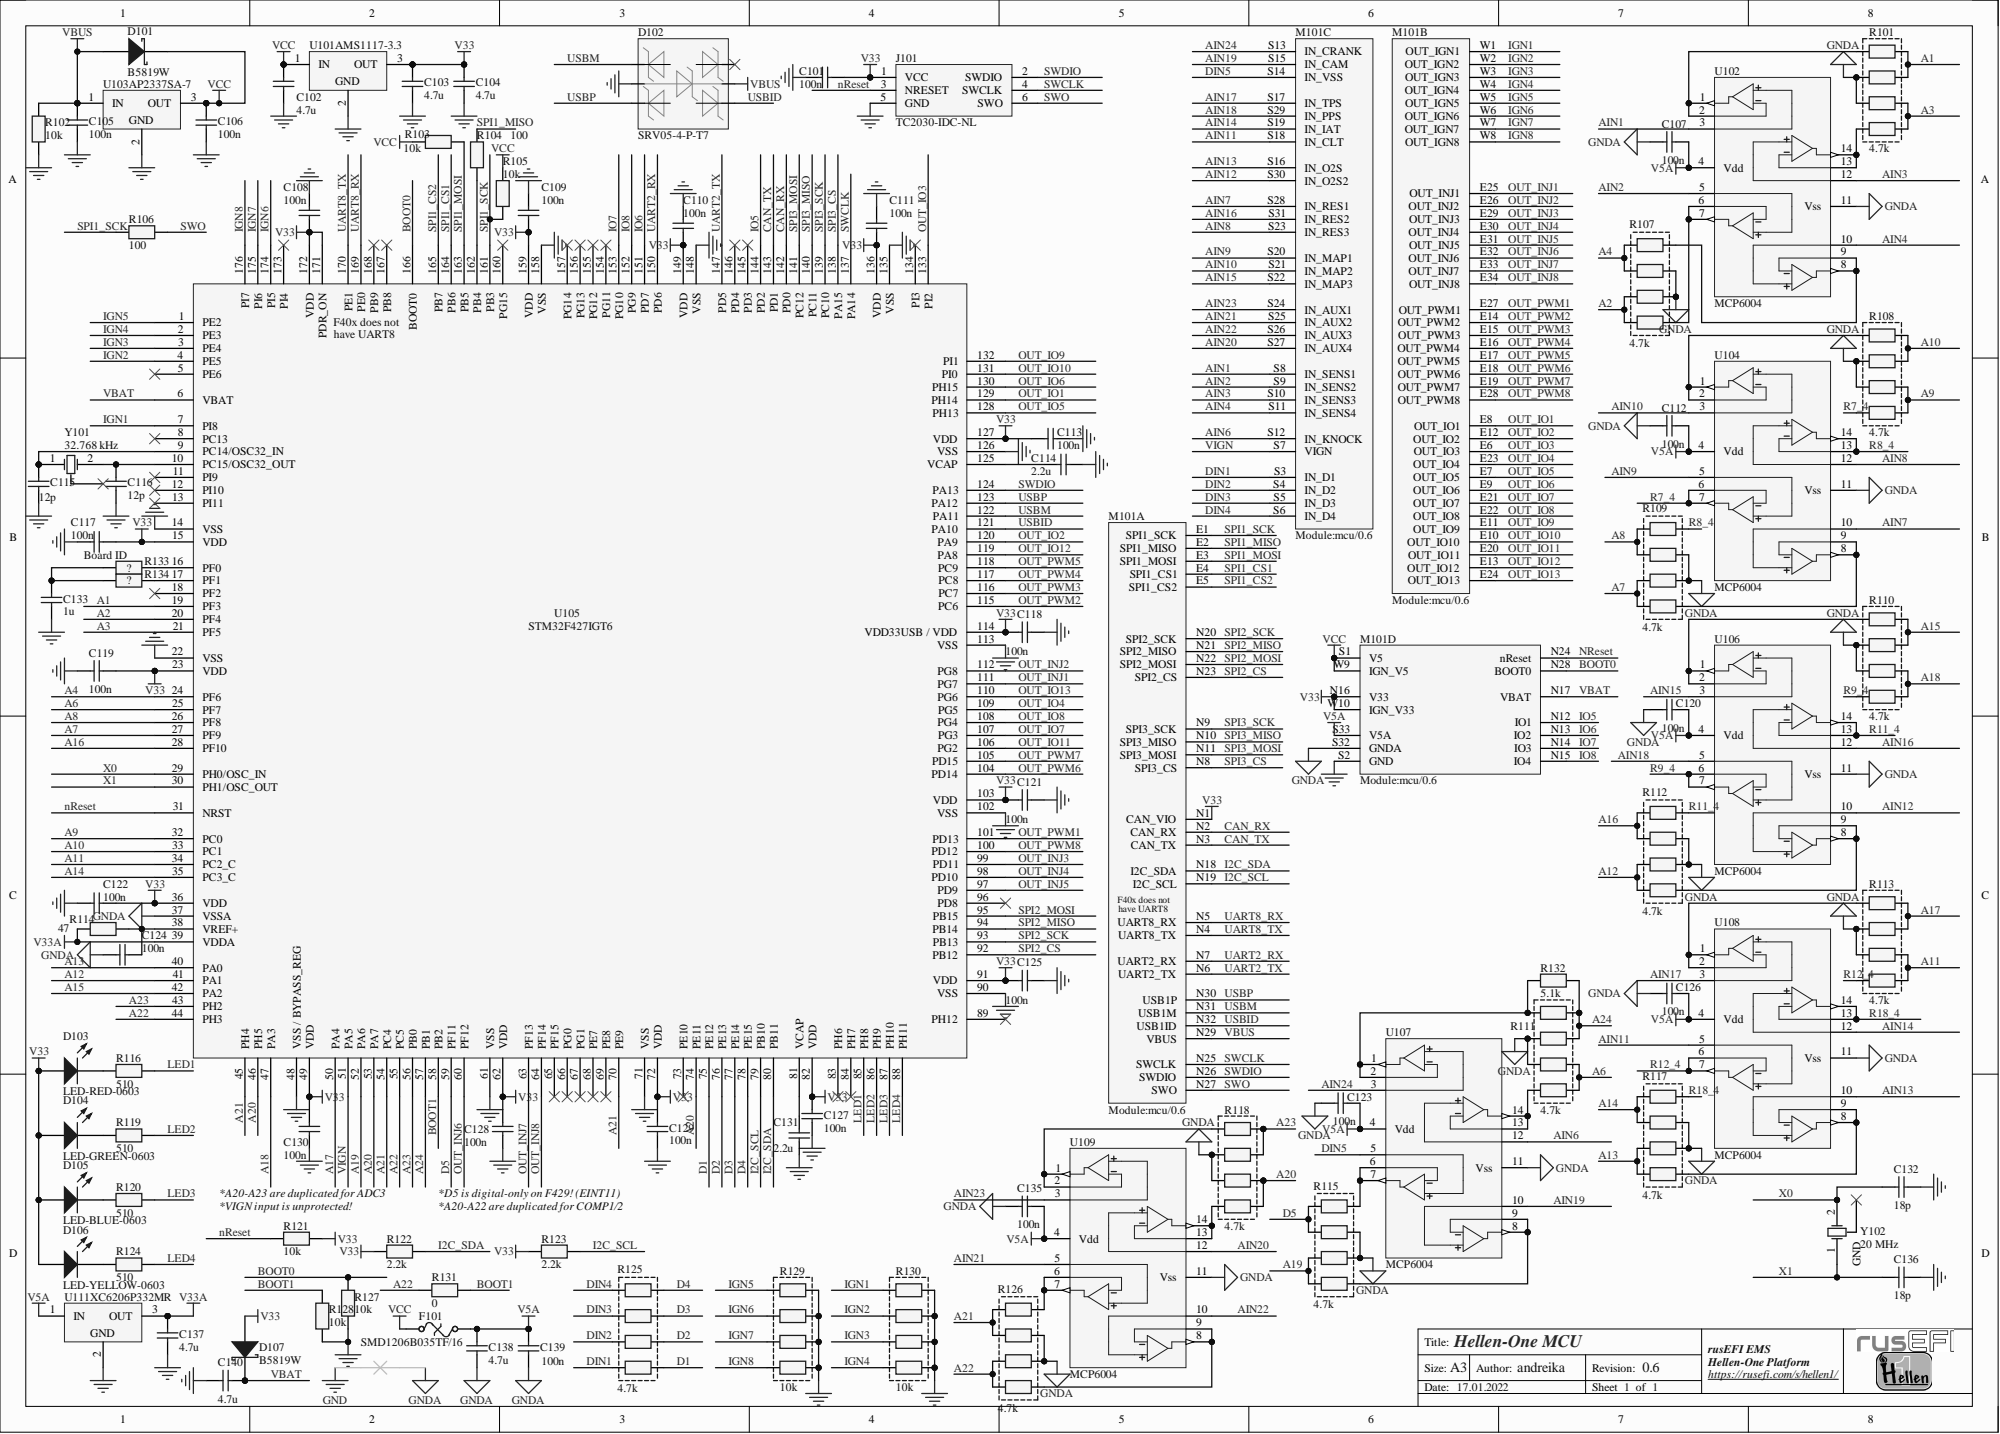
[picture p44: page 4]

D5 *D5 is digital-only on F429!(EINT11)

*A20-A23 are duplicated for ADC3
*VIGN input is unprotected!

2 SPI_I; 3 GND; 4 VCC; 5 SPI_SCK; 6 GND; 7 SPI_O; Molex MicroSD 47219-2001; GND; SD_CS SD_MOSI; SD_SCK; SD_MISO; V2 GND; SD_MOSI V5; SD_SCK V6 SD_MISO V7; Module:sd/0.1; SD_MOSI; SD_SCK SD_MISO

Hellen-One SD-Card


* These can be removed in the board compilation file

tfo rm m/s/h; Size:; Rev; Shee; VCC

Hellen-One VR andreika

rusEFI EMS https://rusefi.co
Hellen-One

nReset 1; SWDIO; GND 3; GND; SWO 5; SWCLK; ST/Link 2x5; nReset; SWO; 2 OUT 3; SWO N3; SWDIO N4; N1 SWCLK N5; nReset N6; Module:stlink/0.1; SWDIO SWO

Hellen-One ST-Link

PESD1CAN; GND; CANH; CANL; TXD 1 GND 2 VCC 3; Vio; 5 RXD 4; 6 CANH; TJA1051T/3/1J; CANH CANL; CAN_TX; CAN_RX; CAN_VIO; CAN_VIO V2; S2 CANL; CAN_TX V5; CAN_RX V6; Module:can/0.1

Hellen-One CAN


tfo rm m/s/h; Hellen-One Power1 2; dreik; Size:; Rev; Shee; VBA; GND S1; Hel; len O; wer-1; terface; VIGN; overvo; tect; 8 SMCJ; 1 PSM7; MIC5

rusEFI EMS https://rusefi.co
Hellen-One


1kR600

3.3k R623


Pump Current Sense Nernst Sense

LSU_Vm
Pump Driver Nernst Internal Resistance Measurement

1 VO 2 VI 3 U604 XC6206P332MR GND GND

1 PA4 10 PA5 11 PA6 12 PA7 13 PB0 14 PB1 15 VSS 16 VDDIO2 17 PA8 18 PA9 19 PF0 2 PA10 20 PA11 21 PA12 22 PA13 23 PA14 24 PA15 25 PB3 26 PB4 27 PB5 28 PB6 29 PF1 3 PB7 30 PB8 31 VSSA 32 NRST 4 VDDA

LED-RED-0603 ¹⁰⁰n C⁶⁰⁵ C604 DNP

Nernst Sense Voltage Buffer

1k GND GND R⁶¹⁶ ¹k

File: hellen1-wbo.kicad_sch Sheet: / rusefi.com
