iankeeffe1/hellen-example/(commit log)

2024-06-24 Add Boards and Gerbers
    [64_NA6_94-BOM.csv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]
2024-06-24 Add .kicad_pcb
2024-06-24 Add NA6
    [board_id_na6_94-c.csv, board_id_na6_94-d.csv, bom_replace_64_miataNA6_94-b.csv, bom_replace_hellen64_NA6_94-c.csv, bom_replace_hellen64_NA6_94-d.csv, hellen64_NA6_94.kicad_sch, hellen64_miataNA6_94.kicad_pcb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]
2024-06-24 [skip actions] Auto-generated board v2.1
    [hellen64_NA6_94-B_Cu.gbl, hellen64_NA6_94-B_Mask.gbs, hellen64_NA6_94-B_Paste.gbp, hellen64_NA6_94-B_Silkscreen.gbo, hellen64_NA6_94-Edge_Cuts.gm1, hellen64_NA6_94-F_Cu.gtl, hellen64_NA6_94-F_Mask.gts, hellen64_NA6_94-F_Paste.gtp]
